dylanfalzone/Cansat_2023/README.md

# Cansat_2023
Design team project including design reviews and C code for a miniature satellite that placed 4th in the U.S. and 13th internationally at the 2023 Cansat Competition. For a full description of my work on this project, check my linkedin: https://www.linkedin.com/in/dylan-falzone-98a7b81b6/

* NOTE: The files in this repo were a collaborative effort from an incredible team. All members have given permission for the files to be viewed here.
