dylanfalzone/Cansat_2023/Cansat 2023 PDR Outline v1.1.pdf

# CanSat 2023

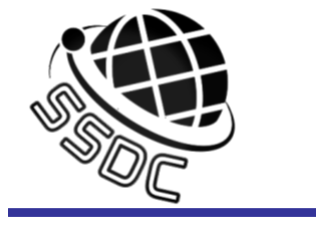
[picture p64: figure]
Team Logo Here (If You Want)

# Preliminary Design Review (PDR) Outline Version 1.0

# Team 1032 Yes we CANSAT

CanSat 2023 PDR: Team 1032 Yes we CANSAT | 1

(If You Want) | Presentation Outline
Presenter: Savari Datta | CanSat 2023 PDR: Team 1032 Yes we CANSAT | 2
Page # | Presentation Section | Presenter(s)
5 | Systems Overview | Savari Datta, Jordi Rey, Daniel Horton
20 | Sensor Subsystem Design | Dylan Falzone
30 | Descent Control Design | Jovana Markovic, Melissa Gonzalez Grospe
40 | Mechanical Subsystem Design | Daniel Horton, Christian Roque, Savari Datta, Melissa Gonzalez Grospe
55 | Communication and Data Handling (CDH) Subsystem Design | Yashas Shivaram, Max Epstein
65 | Electrical Power Subsystem (EPS) Design | Paolo D’Alessandro
70 | Flight Software (FSW) Design | Max Epstein
80 | Ground Control System (GCS) Design | Dylan Falzone, Max Epstein
87 | CanSat Integration and Test | Jordi Rey, Yashas Shivaram
95 | Mission Operations & Analysis | Jordi Rey
100 | Requirements Compliance | Savari Datta
108 | Management | Savari Datta

# (If You Want) Team Organization

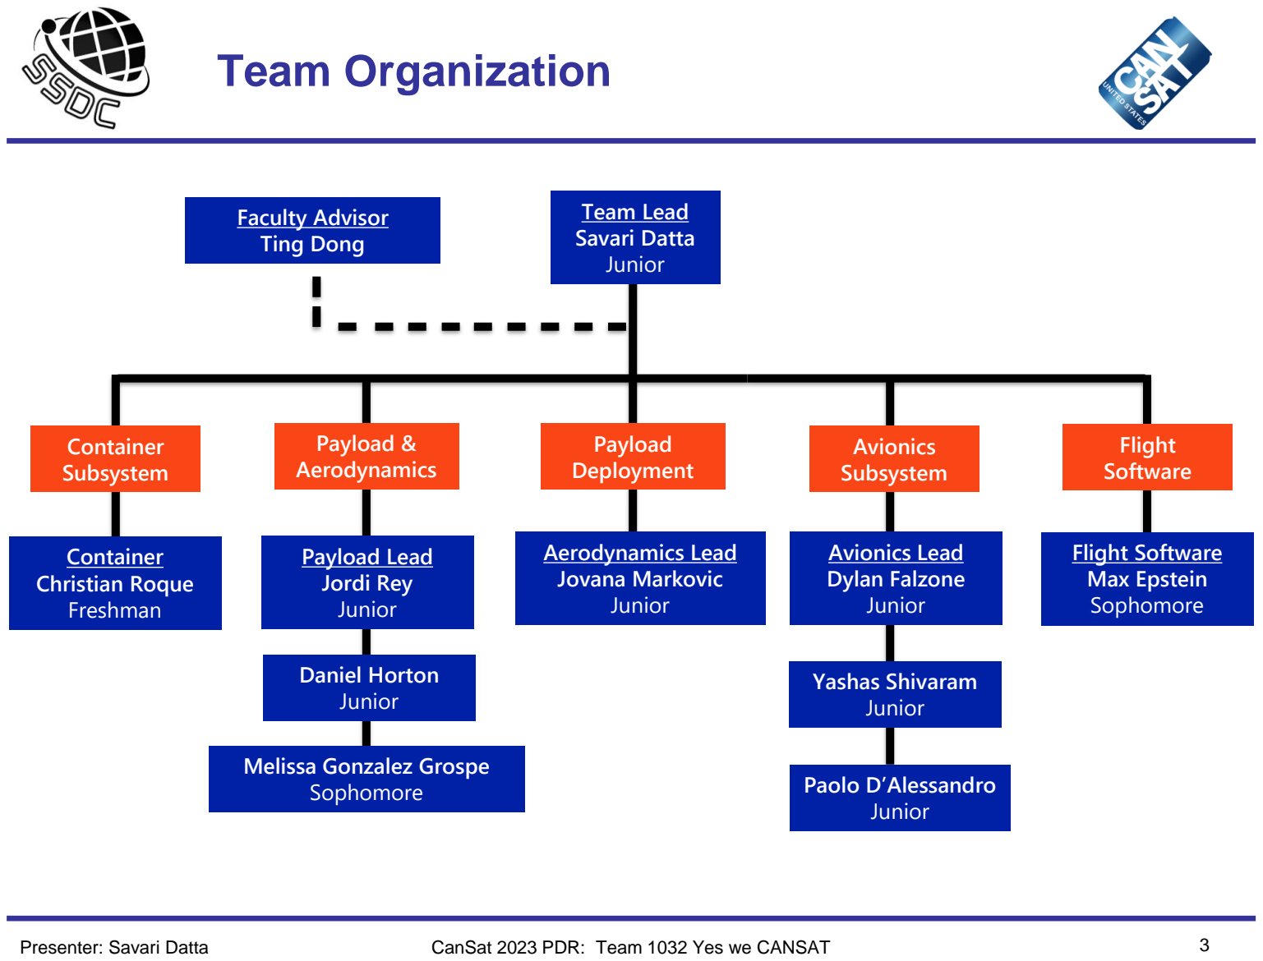
[picture p65: page 3]

Presenter: Savari Datta | CanSat 2023 PDR: Team 1032 Yes we CANSAT | 3

Team Lead
Savari Datta
Junior

Faculty Advisor
Ting Dong

Container
Subsystem

Payload
Deployment

Avionics
Subsystem

Container
Christian Roque
Freshman

Aerodynamics Lead
Jovana Markovic
Junior

Avionics Lead
Dylan Falzone
Junior

Payload &
Aerodynamics

Payload Lead
Jordi Rey
Junior

Melissa Gonzalez Grospe
Sophomore

Yashas Shivaram
Junior

Flight
Software

Flight Software
Max Epstein
Sophomore

Daniel Horton
Junior

Paolo D’Alessandro
Junior

(If You Want) | Acronyms
Presenter: Savari Datta | CanSat 2023 PDR: Team 1032 Yes we CANSAT | 4
Acronym | Meaning
ABS | Acrylonitrile Butadiene Styrene
CD | Drag Coefficient
CDH | Communication and Data Handling
CSV | Comma-Separated Values
DAC | Digital-to-Analog Converter
EPS | Electrical Power Subsystem
FSW | Flight Software
GCS | Ground Control System
GPS | Global Positioning System
IDE | Integrated Development Environment
LED | Light-Emitting Diode
MAE | Mechanical & Aerospace Engineering
Acronym | Meaning
MQTT | MQ Telemetry Transport
OTS | Off-the-shelf
PDR | Preliminary Design Review
PID | Proportional-Integral-Derivative
PWM | Pulse-Width Modulation
RPM | Revolutions per Minute
SMA | Subminiature Version A
SPI | Serial Peripheral Interface
SSDC | Space Systems Design Club
STEM | Science, Technology, Engineering, and Mathematics
UF | University of Florida

# Systems Overview

# Savari Datta, Jordi Rey, Daniel Horton

CanSat 2023 PDR: Team 1032 Yes we CANSAT | 5

(If You Want) | Mission Summary (1/2)
Presenter: Savari Datta | CanSat 2023 PDR: Team 1032 Yes we CANSAT | 6

## Main Objectives:

Design a CanSat that shall consist of a container and a payload. The probe shall simulate the sequence of a planetary probe

- The CanSat shall be launched to an altitude ranging from 670 meters to 725 meters above the launch site and deployed near apogee (peak altitude).
- The CanSat must survive the forces incurred at launch and deployment.
- Once the CanSat is deployed from the rocket, the CanSat shall descend using a parachute at a rate of 15 m/s.
- At 500 meters, the CanSat shall deploy a probe that shall open a heat shield.
- The heat shield will be used as an aerobraking device with a descent rate of 20 meters/second or less.
- When the probe reaches 200 meters, the probe shall deploy a parachute and slow the descent rate to 5 meters/second.
- Once the probe has landed, it shall attempt to upright itself and raise a flag 500 mm above the base of the probe.
- The video camera shall be pointed towards the ground during descent.

(If You Want) | Mission Summary (2/2)
Presenter: Savari Datta | CanSat 2023 PDR: Team 1032 Yes we CANSAT | 7

## Bonus Objectives:

A video camera shall be integrated into the container and point toward the probe. The camera shall record the event when the probe is released from the container. Video shall be in color with a minimum resolution of 640x480 pixels and a minimum of 30 frames per second.

- Will not be attempting bonus objective

## External Objectives:

- To promote STEM engagement at the university level
- To provide team members with valuable hands-on engineering project experience
that includes designing, manufacturing and testing of an aerospace system
- To challenge students with unique projects that require critical thinking
- To inspire underclassmen to continue participating in the annual CanSat competition at UF

(If You Want) | System Requirement Summary (1/6)
Presenter: Savari Datta | CanSat 2023 PDR: Team 1032 Yes we CANSAT | 8
Requirement Number | Description
1 | Total mass of the CanSat (science payloads and container) shall be 700 grams +/- 10 grams.
2 | CanSat shall fit in a cylindrical envelope of 125 mm diameter x 400 mm length. Tolerances are to be included to facilitate container deployment from the rocket fairing.
3 | The container shall not have any sharp edges to cause it to get stuck in the rocket payload section which is made of cardboard.
4 | The container shall be a fluorescent color; pink, red or orange.
5 | The container shall be solid and fully enclose the science probes. Small holes to allow access to turn on the science probes are allowed. The end of the container where the probe deploys may be open.
6 | The rocket airframe shall not be used to restrain any deployable parts of the CanSat.
7 | The rocket airframe shall not be used as part of the CanSat operations.
8 | The container’s parachute shall not be enclosed in the container structure. It shall be external and attached to the container so that it opens immediately when deployed from the rocket.
9 | The Parachutes shall be fluorescent Pink or Orange
10 | The descent rate of the CanSat (container and science probe) shall be 15 meters/second +/- 5m/s.
11 | 0 altitude reference shall be at the launch pad.

(If You Want) | System Requirement Summary (2/6)
Presenter: Savari Datta | CanSat 2023 PDR: Team 1032 Yes we CANSAT | 9
Requirement Number | Description
12 | All structures shall be built to survive 15 Gs of launch acceleration.
13 | All structures shall be built to survive 30 Gs of shock
14 | All electronics and mechanical components shall be hard mounted using proper mounts such as standoffs, screws, or high-performance adhesives.
15 | All mechanisms shall be capable of maintaining their configuration or states under all forces.
16 | Mechanisms shall not use pyrotechnics or chemicals.
17 | Mechanisms that use heat (e.g., nichrome wire) shall not be exposed to the outside environment to reduce potential risk of setting vegetation on fire.
18 | Both the container and payload shall be labeled with team contact information including email address.
19 | Cost of the CanSat shall be under $1000. Ground support and analysis tools are not included in the cost. Equipment from previous years should be included in this cost, based on current market value.
20 | XBEE radios shall be used for telemetry. 2.4 GHz Series radios are allowed. 900 MHz XBEE radios are also allowed.
21 | XBEE radios shall have their NETID/PANID set to their team number.
22 | XBEE radios shall not use broadcast mode.
23 | The container and probe shall include an easily accessible power switch that can be accessed without disassembling the CanSat and science probes and in the stowed configuration.

(If You Want) | System Requirement Summary (3/6)
Presenter: Savari Datta | CanSat 2023 PDR: Team 1032 Yes we CANSAT | 10
Requirement Number | Description
24 | The probe shall include a power indicator such as an LED or sound generating device that can be easily seen or heard without disassembling the CanSat and in the stowed state.
25 | An audio beacon is required for the probe. It shall be powered after landing.
26 | The audio beacon shall have a minimum sound pressure level of 92 dB, unobstructed.
27 | Battery source may be alkaline, Ni-Cad, Ni-MH or Lithium. Lithium polymer batteries are not allowed. Lithium cells must be manufactured with a metal package similar to 18650 cells. Coin cells are allowed.
28 | An easily accessible battery compartment shall be included allowing batteries to be installed or removed in less than a minute and not require a total disassembly of the CanSat.
29 | Spring contacts shall not be used for making electrical connections to batteries. Shock forces can cause momentary disconnects.
30 | The CanSat shall operate during the environmental tests laid out in Section 3.5.
31 | The CanSat shall operate for a minimum of two hours when integrated into the rocket.
32 | The probe shall be released from the container when the CanSat reaches 500 meters.
33 | The probe shall deploy a heat shield after leaving the container.
34 | The heat shield shall be used as an aerobrake and limit the descent rate to 20 m/s or less.
35 | At 200 meters, the probe shall release a parachute to reduce the descent rate to 5 m/s +/- 1m/sec.

(If You Want) | System Requirement Summary (4/6)
Presenter: Savari Datta | CanSat 2023 PDR: Team 1032 Yes we CANSAT | 11
Requirement Number | Description
36 | Once landed, the probe shall upright itself.
37 | After uprighting, the probe shall deploy a flag 500 mm above the base of the probe when the probe is in the upright position.
38 | The probe shall transmit telemetry once per second.
39 | The probe telemetry shall include altitude, air pressure, temperature, battery voltage, probe tilt angles, command echo, and GPS coordinates that include latitude, longitude, altitude and number of satellites tracked.
40 | The probe shall include a video camera pointing down to the ground.
41 | The video camera shall record the flight of the probe from release to landing.
42 | The video camera shall record video in color and with a minimum resolution of 640x480.
44 | The flight software shall maintain a count of packets transmitted which shall increment with each packet transmission throughout the mission. The value shall be maintained through processor resets
45 | The probe shall maintain mission time throughout the whole mission even with processor resets or momentary power loss.
46 | The probe shall have its time set to within one second UTC time prior to launch.
47 | The probe flight software shall support simulated flight mode where the ground station sends air pressure values at a one second interval using a provided flight profile csv file.
48 | In simulation mode, the flight software shall use the radio uplink pressure values in place of the pressure sensor for determining the container altitude.

(If You Want) | System Requirement Summary (5/6)
Presenter: Savari Datta | CanSat 2023 PDR: Team 1032 Yes we CANSAT | 12
Requirement Number | Description
49 | The container flight software shall only enter simulation mode after it receives the SIMULATION ENABLE and SIMULATION ACTIVATE commands.
50 | The ground station shall command the CanSat to start calibrating the altitude to zero when the CanSat is on the launch pad prior to launch.
51 | The ground station shall generate csv files of all sensor data as specified in the Telemetry Requirements section.
52 | Telemetry shall include mission time with 0.01 second or better resolution.
53 | Configuration states such as zero altitude calibration shall be maintained in the event of a processor reset during launch and mission.
54 | Each team shall develop their own ground station.
55 | All telemetry shall be displayed in real time during descent on the ground station.
56 | All telemetry shall be displayed in engineering units (meters, meters/sec, Celsius, etc.)
57 | Teams shall plot each telemetry data field in real time during flight.
58 | The ground station shall include one laptop computer with a minimum of two hours of battery operation, XBEE radio and a hand-held antenna.
59 | The ground station must be portable so the team can be positioned at the ground station operation site along the flight line. AC power will not be available at the ground station operation site
60 | The ground station software shall be able to command the container to operate in simulation mode by sending two commands, SIMULATION ENABLE and SIMULATION ACTIVATE.

(If You Want) | System Requirement Summary (6/6)
Presenter: Savari Datta | CanSat 2023 PDR: Team 1032 Yes we CANSAT | 13
Requirement Number | Description
61 | When in simulation mode, the ground station shall transmit pressure data from a csv file provided by the competition at a 1 Hz interval to the CanSat.

# System Level CanSat Configuration Trade & Selection

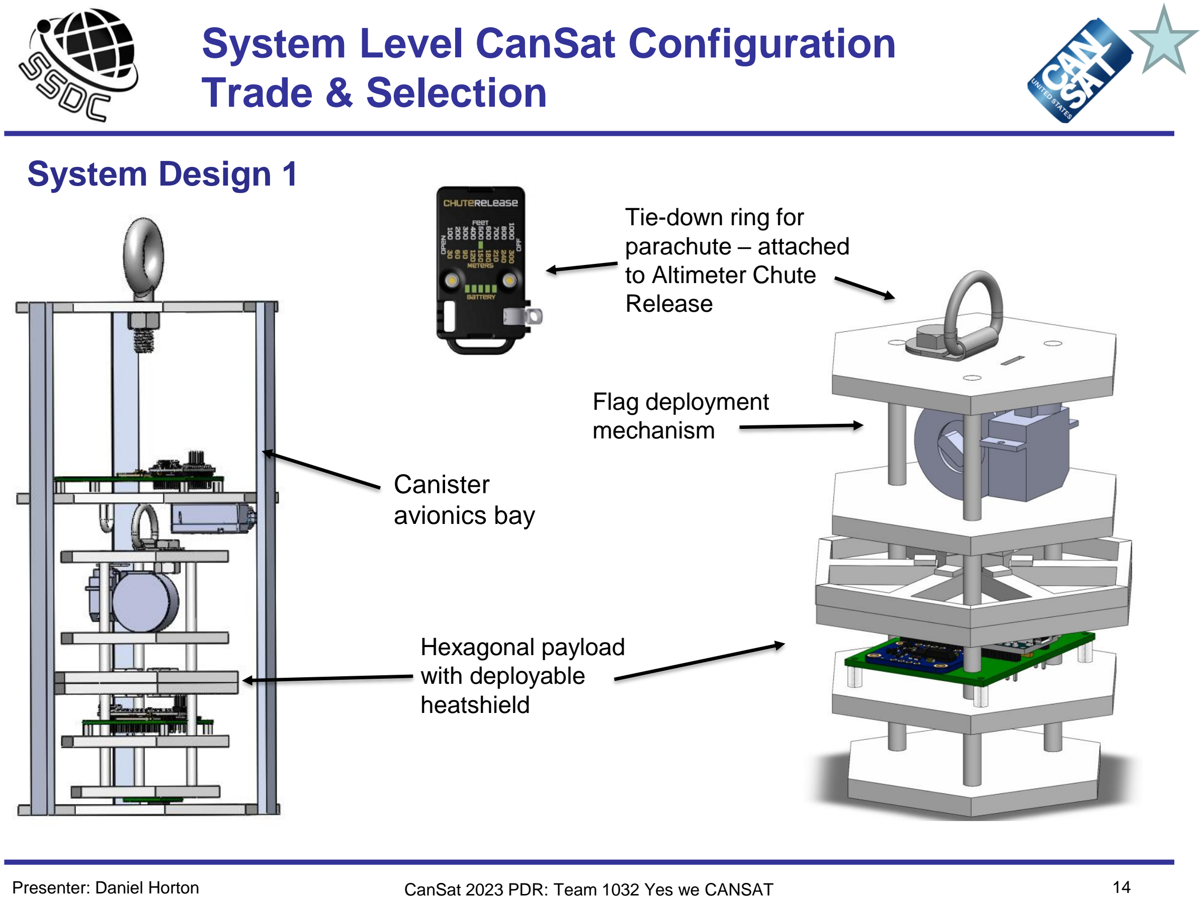
[picture p66: page 14]

(If You Want)

Presenter: Daniel Horton | CanSat 2023 PDR: Team 1032 Yes we CANSAT | 14

## System Design 1

Canister
avionics bay

Hexagonal payload
with deployable
heatshield

Flag deployment
mechanism

Tie-down ring for
parachute – attached
to Altimeter Chute
Release

# System Level CanSat Configuration Trade & Selection

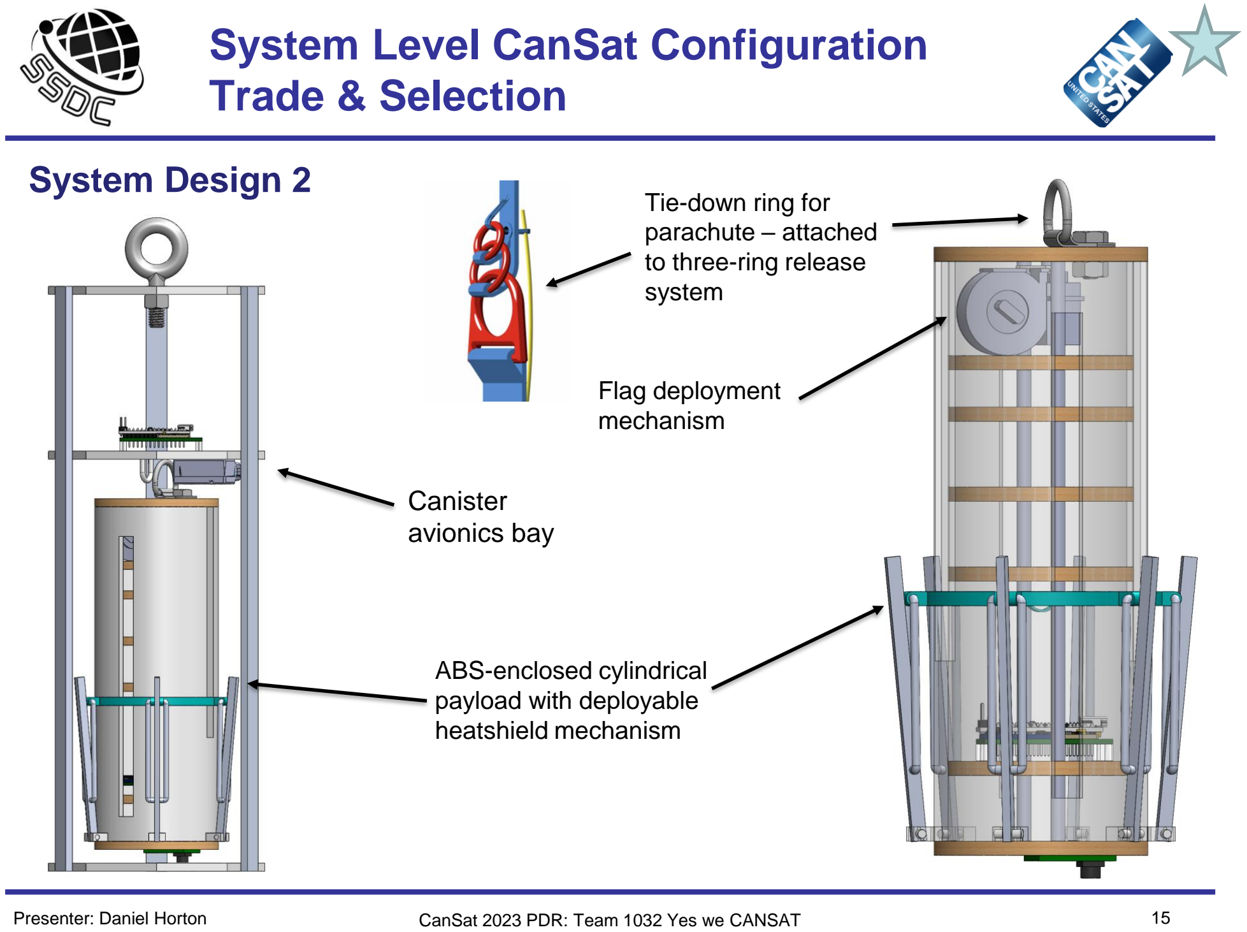
[picture p67: page 15]

(If You Want)

Presenter: Daniel Horton | CanSat 2023 PDR: Team 1032 Yes we CANSAT | 15

## System Design 2

Canister
avionics bay

ABS-enclosed cylindrical
payload with deployable
heatshield mechanism

Flag deployment
mechanism

Tie-down ring for
parachute – attached
to three-ring release
system

(If You Want) | System Level Configuration Selection
Presenter: Daniel Horton | CanSat 2023 PDR: Team 1032 Yes we CANSAT | 16

Chosen Design: System 1

Configuration | Reasoning
9-sided polygon Canister | Simple to manufacture, light-weight design, composed only of ABS plastic plates, fiberglass eyebolt and aluminum supports fixed together using epoxy.
Hexagonal payload configuration | ABS plates with 6 spring-deployed arms for the aerobraking-heatshield, and aluminum rods supporting the plates. More compact design with fewer unique parts required, making it easier to manufacture.
Altimeter Chute Release | Electronic chute release; does not require any other mechanical components on the payload to deploy the parachute when the desired altitude is reached.

# (If You Want) Physical Layout

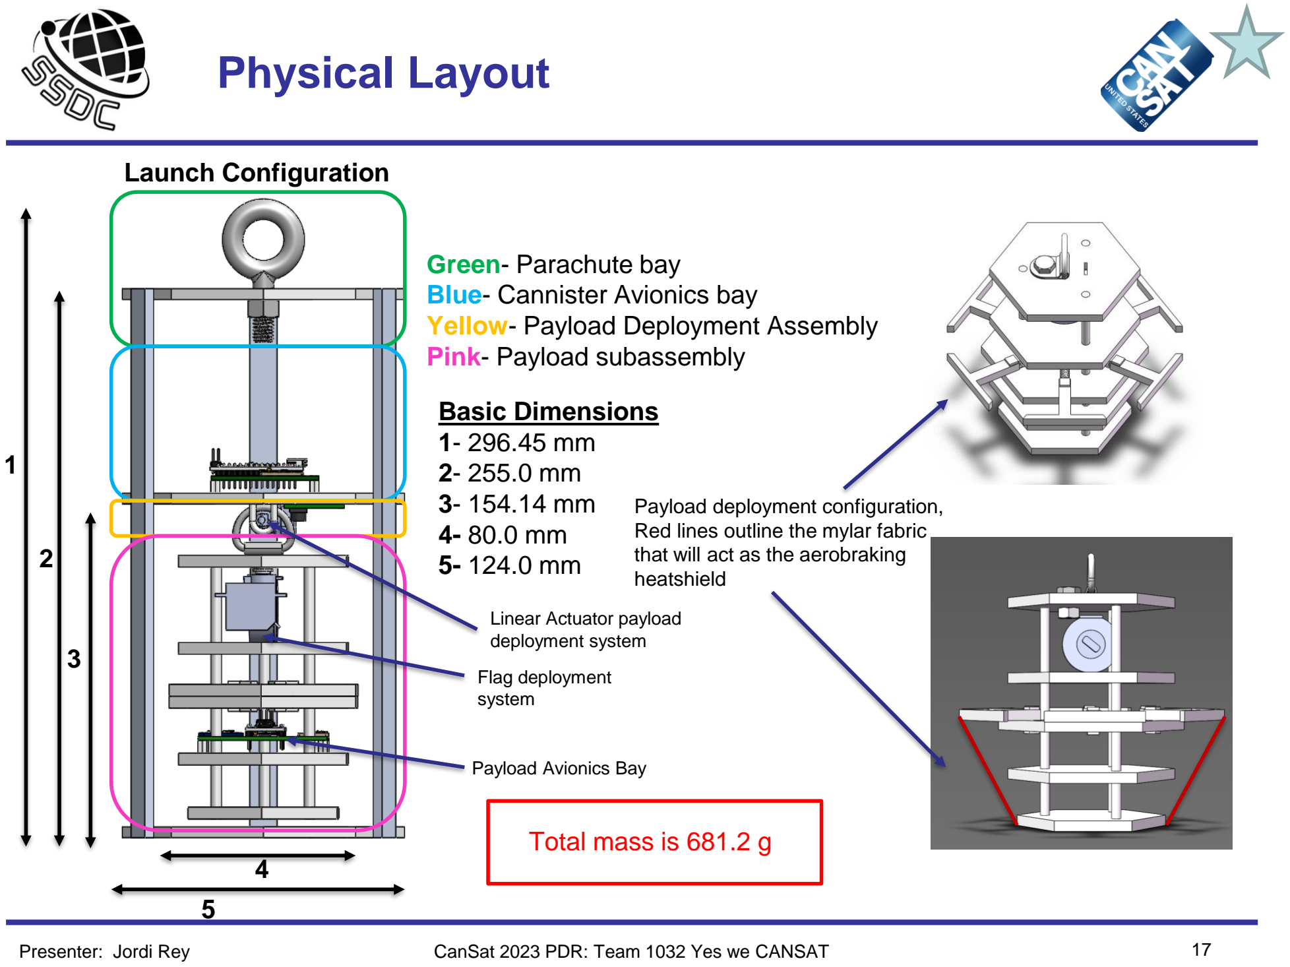
[picture p68: page 17]

Presenter: Jordi Rey | CanSat 2023 PDR: Team 1032 Yes we CANSAT | 17

Launch Configuration

1

2

3

4
5

Basic Dimensions
1- 296.45 mm
2- 255.0 mm
3- 154.14 mm
4- 80.0 mm
5- 124.0 mm

Green- Parachute bay
Blue- Cannister Avionics bay
Yellow- Payload Deployment Assembly Pink- Payload subassembly

Flag deployment
system

Linear Actuator payload
deployment system

Payload Avionics Bay

Payload deployment configuration, Red lines outline the mylar fabric that will act as the aerobraking heatshield

Total mass is 681.2 g

(If You Want) | System Concept of Operations

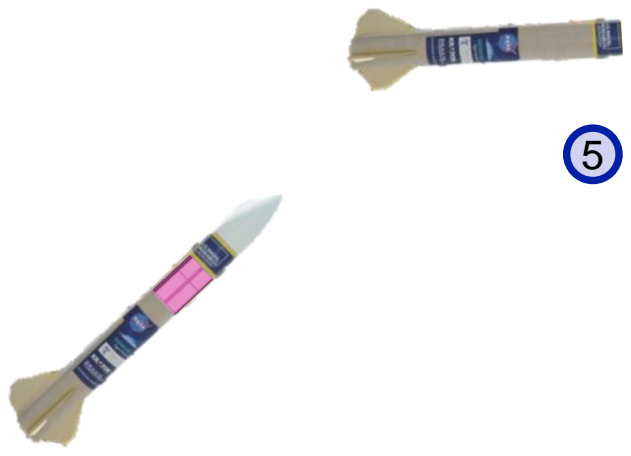
[picture p69: figure]
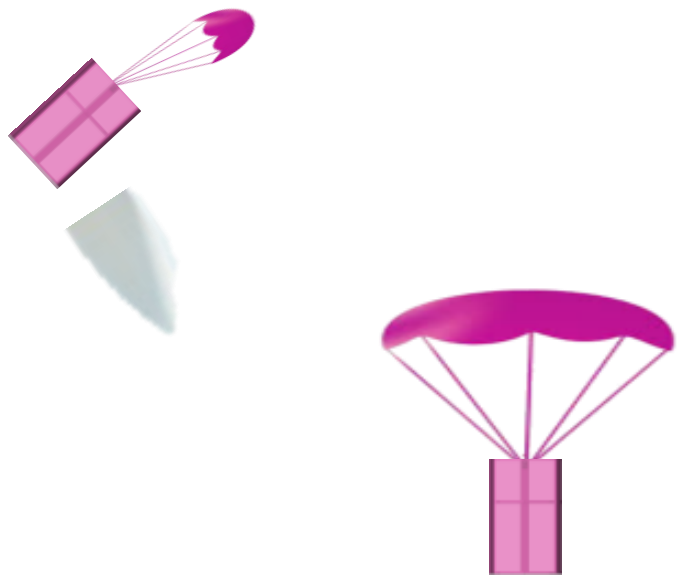
[picture p70: figure]
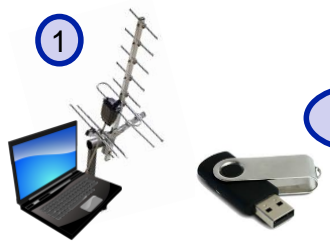
[picture p71: figure]

Presenter: Jordi Rey | CanSat 2023 PDR: Team 1032 Yes we CANSAT | 18
1. Set up ground station
2. Power on CanSat
3. Place CanSat into rocket
4. Rocket is launched
5. At 670-725m the CanSat separates and parachute opens
6. At 400m a probe will be released from the CanSat, which will deploy an aerobraking heat shield, with a camera facing the ground at all times
7. At 200m the probe will deploy a parachute too reduce descent rate
8. Probe will land upright
9. Probe will deploy a flag 500mm above the base of the probe
10. Recovery crew tracks and collects CanSat
11. FSW obtains and saves flight data & video recording to thumb drive ¹

2
3

4

6

7

9 | 8
10

11

(If You Want) | Launch Vehicle Compatibility

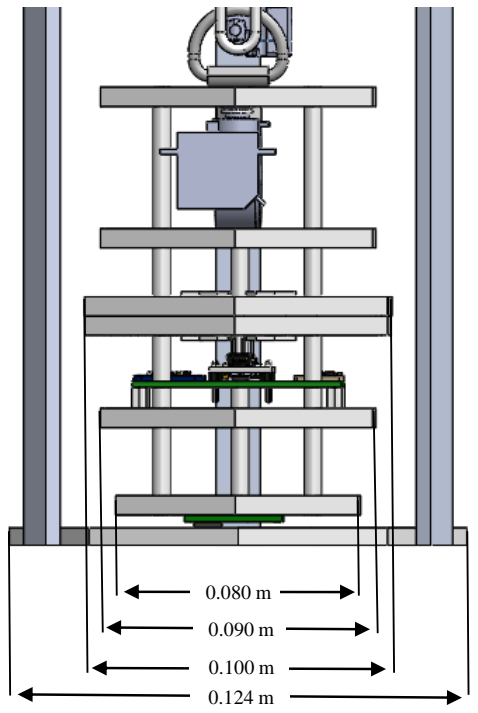
[picture p72: figure]

Presenter: Jordi Rey | CanSat 2023 PDR: Team 1032 Yes we CANSAT | 19

# Payload Clearance

NOTE: The first two
plates are the same
size as the third plate
(0.090 m)

Sharp edges in this section will be sanded down

# Sensor Subsystem Design

# Dylan Falzone

CanSat 2023 PDR: Team 1032 Yes we CANSAT | 20

(If You Want) | Sensor Subsystem Overview
Presenter: Dylan Falzone | CanSat 2023 PDR: Team 1032 Yes we CANSAT | 21
Sensor Type | Model | Purpose | CanSat Location
GPS module | Adafruit Ultimate | Determine location coordinates (X,Y,Z) & exact time | Payload
Pressure Sensor | Adafruit BMP280 | Measure altitude of Container & Payload | Container, Payload
Rotational Sensor | BNO055 | Measure gyro readings in degrees per second, angular acceleration, and magnetometer readings in gauss | Payload
Temperature Sensor | BNO055 | Measure temperature readings | Payload
Camera | Arducam Mini 2MP Plus | View and record Earth’s terrain during descendent | Payload

(If You Want)

# Payload Air Pressure Sensor Trade & Selection


22

Sensors | Current (at 1Hz) (µA) | Temperature Range (°C) | Interfaces | Resolution (hPa) | Voltage Usage (V) | Size (mm) L x W x H | Weight (g) | Price ($)
Adafruit MPRLS | 3.6 | -40 to 85 | I2C, SPI | .30 | 1.65 ~ 3.6 | 17.8 x 16.7 x 7.5 | 1.1 | 14.95
BMP280 Adafruit | 2.7 | -40 to 85 | I2C, SPI | .0016 | 1.71 ~ 3.6 | 19.2 x 17.9 x 2.9 | 1.3 | 9.95
MPL3115A2 | 8.5 | -40 to 85 | I2C | .015 | 1.95~ 3.6 | 18 x 19 x 2 | 1.2 | 9.95
Selection | Reasoning for the selection
Adafruit BMP280 | - Lower current draw in comparison to . other inspected sensors - Greater resolution in comparison to . other inspected sensors
Presenter: Dylan Falzone | CanSat 2023 PDR: Team 1032 Yes we CANSAT

(If You Want)

# Payload GPS Sensor Trade & Selection

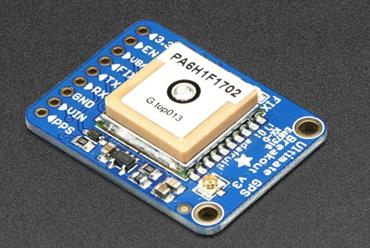
[picture p73: figure]

23

Sensors | Update Rate (Hz) | Operating Voltage (V) | Current (Tracking) (mA) | Interfaces | Size (mm) L x W x H | Weight (g) | Price ($)
Adafruit Ultimate Breakout v3 | 10 | 3.0 – 5.0 | 20 | I2C, SPI, UART | 25.5 x 35 x 6.5 | 8.5 | 29.95
uBlox NEO M8N | 10 | 2.7 – 3.6 | 23 | I2C, SPI, UART | 27.6 x 26.6 x 2.4 | 9.8 | 11.59
Titan X1 | 10 | 3.0 – 4.3 | 25 | I2C, SPI, UART | 12.5 x 12.5 6.5 | 4 | 69.84
Selection | Reasoning for the selection
Adafruit Ultimate | - Lower current draw during . tracking in comparison to other . inspected sensors - Previous experience with sensor . and familiarity with Arduino - Availability
Presenter: Dylan Falzone | CanSat 2023 PDR: Team 1032 Yes we CANSAT

(If You Want)

# Payload Air Temperature Sensor Trade & Selection


24

Sensors | Temperature Range (°C) | Interfaces | Voltage Usage (V) | Size (mm) L x W x H | Weight (g) | Price ($)
HTU31 Temperature & Humidity Sensor | -40 to 125 | I2C | 3.3 – 5.5 | 25.5 x 17.7 x 4.6 | 1.6 | 5.95
BNO055 | -40 to 85 | I2C or UART | 1.7 – 3.6 | 20 x 27 x 4 | 3 | 34.95
Sensirion SHT31-D | -40 to 125 | I2C | 2.4 – 5.5 | 12.7 x 18 x 2.6 | 0.8 | 13.95
Presenter: Dylan Falzone | CanSat 2023 PDR: Team 1032 Yes we CANSAT
Selection | Reasoning for the selection
BNO 055 | - Familiarity with sensor - Also meets our requirements for . the payload’s temperature sensor - Availability

(If You Want)

# Payload Tilt Sensor Trade & Selection

25

Selection | Reasoning for the selection
BNO 055 | - Familiarity with sensor - Also meets our requirements for . the payload’s temperature sensor - Availability
Sensors | Temperature Range (°C) | Interfaces | Voltage Usage (V) | Size (mm) L x W x H | Weight (g) | Price ($)
HTU31 Temperature & Humidity Sensor | -40 to 125 | I2C | 3.3 – 5.5 | 25.5 x 17.7 x 4.6 | 1.6 | 5.95
BNO055 | -40 to 85 | I2C or UART | 1.7 – 3.6 | 20 x 27 x 4 | 3 | 34.95
Sensirion SHT31-D | -40 to 125 | I2C | 2.4 – 5.5 | 12.7 x 18 x 2.6 | 0.8 | 13.95
Presenter: Dylan Falzone | CanSat 2023 PDR: Team 1032 Yes we CANSAT

(If You Want)

# Payload Battery Voltage Sensor Trade & Selection


Presenter: Dylan Falzone | CanSat 2023 PDR: Team 1032 Yes we CANSAT | 26
Sensors | Resolution | Interfaces | Size (mm) L x W x H | Weight (g) | Price ($)
Adafruit INA219 | 12 bit | I2C | 25.6 x 20.4 x 4.7 | 4.6 | 9.95
Adafruit INA260 | 16 bit | I2C | 22.9 x 22.8 x 2.7 | 2 | 9.95
Precision LM4040 | 12 bit | I2C | 16 x 12.5 x 2.5 | 0.7 | 7.50
Selection | Reasoning for the selection
Adafruit INA260 | - Greater resolution bit compared to other sensors - Previous experience and familiarity with sensor - Availability

(If You Want) | Payload Camera Trade & Selection

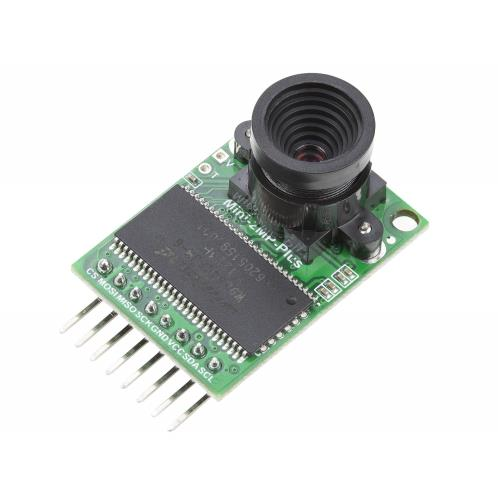
[picture p74: figure]

Presenter: Dylan Falzone | CanSat 2023 PDR: Team 1032 Yes we CANSAT | 27
Selection | Reasoning for the selection
Arducam Mini 2MP Plus | - Compatibility with microprocessor - Lower current draw in comparison to other inspected sensors
Name | Price ($) | Weight (g) | Size (mm) | Operating Voltage (V) | Current Draw (mA) | Framerate (fp s)
Miniature TTL Serial JPEG Camera | 34.95 | 3 | 20 x 28 | 3.3 - 5.0 | 75 | 30
Arducam Mini 2MP Plus | 25.99 | 20 | 24 x 34 | 3.3 - 5.0 | 20 | 30

# (If You Want) Audio Beacon Trade & Selection

28

Name | Pressure (dB) Min Sound | Weight (g) | Operating Voltage (V) | Mini Current Draw (mA)
PS1240P02BT | 60 | 1 | 3 | 40
IE092505-1 | 80 | 1 | 5 | 30

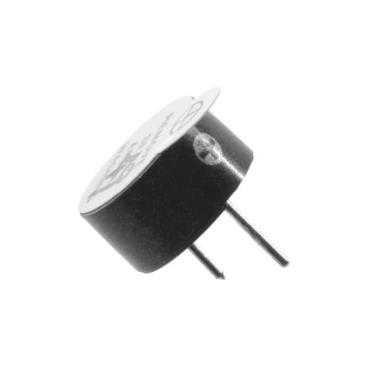
[picture p75: figure]

Selection | Reasoning for the selection
IE092505-1 | - Compatibility with microprocessor - Meet sound level requirement
Presenter: Dylan Falzone | CanSat 2023 PDR: Team 1032 Yes we CANSAT

# (If You Want) Bonus Camera Trade and Selection

- N/A
Presenter: Dylan Falzone | CanSat 2023 PDR: Team 1032 Yes we CANSAT | 29

# Descent Control Design

# Jovana Markovic, Melissa Gonzalez Grospe

CanSat 2023 PDR: Team 1032 Yes we CANSAT | 30

# (If You Want) Descent Control Overview (1/3)

Container Descent Control System:
System: Parachute
System Components: Hexagonal Parachute Parachute Chords
Eyebolt

System Overview: The eyebolt is screwed into the can. The parachute is attached to the eyebolt using chords. The parachute sits atop the can prior to the can’s ejection from the rocket after which the parachute will deploy naturally

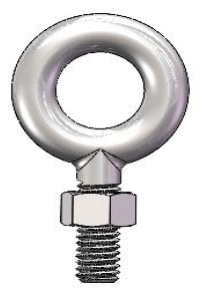
[picture p76: figure]

Presenter: Jovana Markovic | CanSat 2023 PDR: Team 1032 Yes we CANSAT | 31

# (If You Want) Descent Control Overview (2/3)

Payload Descent Control System:
System: Parachute
System Components: Hexagonal Parachute Parachute Chords
Altimeter Chute Release

System Overview: The parachute is attached to a tie down ring which is screwed into the payload. The parachute will sit atop the payload held together by the device until the desired altitude is reached, after which the device will release, and the parachute will be allowed to deploy naturally

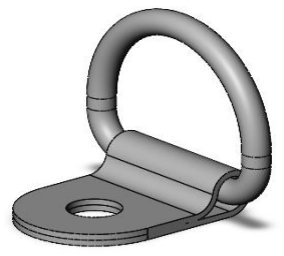
[picture p77: figure]

Presenter: Jovana Markovic | CanSat 2023 PDR: Team 1032 Yes we CANSAT | 32

# (If You Want) Descent Control Overview (3/3)

Aerobraking:
System: Hexagonal Prism Payload Shape System Components: Hexagonal Plates Extendable arms which serve to enlarge one of the plates Spring system which releases the arms into place
Poles for vertical alignment

System Overview: The spring system will allow for the arm attachments to remain compressed while the payload is within the can. Following deployment from the can, the arms will extend and enlarge the surface area of the central hexagonal plate. The enlarged plate will create a truncated hexagonal pyramid which will increase drag.

Presenter: Jovana Markovic | CanSat 2023 PDR: Team 1032 Yes we CANSAT | 33

(If You Want)

# Container Descent Control Strategy Selection and Trade

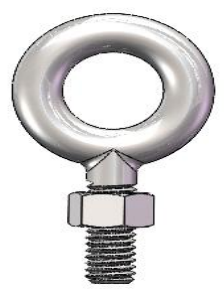
[picture p78: figure]

Presenter: Jovana Markovic | CanSat 2023 PDR: Team 1032 Yes we CANSAT | 34
Decent Control | Eyebolt Design | Tie Down Ring Design
Objective | Weighting Factor | Parameter | Mag. | Score | Value | Mag. | Score | Value
Mass | 0.30 | grams | 10.1 | 9.4 | 2.8 | 15.6 | 6.0 | 1.8
Durability | 0.10 | discussion | good | 8.0 | 0.8 | okay | 6.0 | 0.6
Stability | 0.30 | discussion | great | 10.0 | 3.0 | good | 8.0 | 2.4
Size (Vertical Height) | 0.20 | mm | 66.5 | 3.6 | 0.7 | 23.8 | 10.0 | 2.0
Simplicity | 0.10 | # of parts | 2.0 | 10.0 | 1.0 | 4.0 | 5.0 | 0.5
Overall value | | | | | 8.3 | | | 7.3

Justification: The Eye Bolt design was selected to attach the parachute to the can as it weighs less and requires fewer parts to be installed in comparison to the Tie Down Ring

Configuration A:
Eyebolt

Configuration B:
Tie Down Ring

(If You Want)

# Payload Aerobraking Descent Control Strategy Selection and Trade

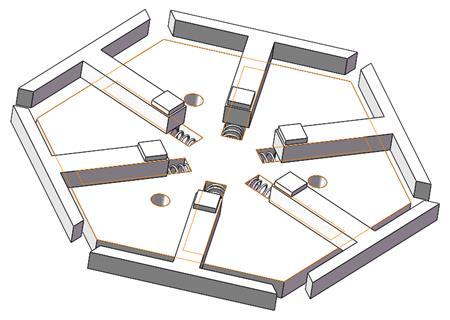
[picture p79: figure]
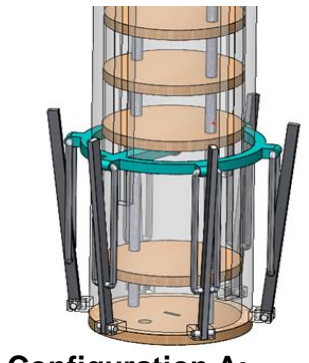
[picture p80: figure]

Presenter: Melissa Gonzalez Grospe | CanSat 2023 PDR: Team 1032 Yes we CANSAT | 35
Design | Description | Identified Issues | Evaluation
Umbrella Mechanism | Following deployment from the can, six rods will release naturally and extend at an angle in order to create an aerodynamic parabolic shape. | Manufacturing the rods to allow for easy movement proved to be difficult. Lack of storage space for electronics. | Discarded
Spring Loaded Hexagon | Following deployment from the can, a spring system will allow for rods to extend on the top plate of the payload. The top plate will now be larger, which will create a cone shaped payload. | Design is heavier than preferred. The bottom of the payload is a hexagonal plate which may disturb the aerodynamics. | Selected, allows for necessary deceleration while being cheaper and easier to manufacture

Configuration A:
Umbrella Mechanism

Configuration B:
Spring Loaded Hexagon

(If You Want)

# Payload Aerobraking Descent Stability Control Strategy Selection and Trade

Presenter: Melissa Gonzalez Grospe | CanSat 2023 PDR: Team 1032 Yes we CANSAT | 36
Method | Description | Identified Issues | Evaluation
Bottom Heavy Payload Design | Designing the payload in a manner in which most of the mechanisms are located towards the center bottom of the payload and distributing the contents of the payload such as the electronics toward the bottom would ensure that the payload lands upright. | Requires extensive testing. Adequate space for the configuration may be an issue. The payload contents may be more susceptible to damage from the shock of deployment in this configuration. | Selected, simple design and preliminary testing has already been completed.
Spinning Payload | The spinning serves the gyroscopically stabilize the payload. | Difficult to implement. The spinning could have a significant effect on the speed at which the payload is descending. | Discarded, impractical

(If You Want)

# Payload Parachute Descent Control Strategy Selection and Trade

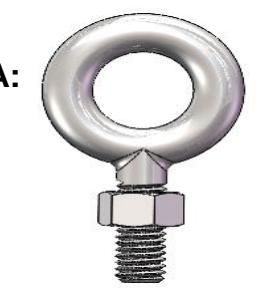
[picture p81: figure]

Presenter: Melissa Gonzalez Grospe | CanSat 2023 PDR: Team 1032 Yes we CANSAT | 37
Method | Description | Identified Issues | Evaluation
Eyebolt | Consists of a 6.6675 cm long shank which anchors the eye bolt to the payload and a ring at the top which allows for attaching the parachute. Would require an additional nut to hold the eye bolt in place. | Vertical height exceeds allowable value. Would add considerable height to the payload design, possibly requiring modifications to the can design in order to accommodate the height. | Discarded
Tie Down Ring | The tie down ring consists of a D shaped ring which is securely nestled within a base plate. The base plate is folded over and through the ring to secure it. The tie down ring is secured to the payload using an additional nut and screw. | Heavier than preferable. More complex manufacturing compared to eyebolt design. Requires more parts. | Selected, shorter possible shank length saves space, shorter overall height.

Configuration A:
Eyebolt

Configuration B:
Tie Down Ring

# (If You Want) Descent Rate Estimates (1/2)

# Decent Rate Estimates for the following Configurations

# Assumptions

- ~2.7 m/s winds
- Total weight is 700 grams
- Payload weight is 300 grams
- 0.53m Hexagon Parachute for Payload
Presenter: Melissa Gonzalez Grospe | CanSat 2023 PDR: Team 1032 Yes we CANSAT | 38
Configuration | Device | Desired Rate | Decent Rate Estimate | Method of Calculation
CanSat with payload | Parachute | 15 ± 5 m/s | 15.3 m/s | Parachute calculations
Payload aerobraking | Umbrella Device | less than 20 m/s | 11.3 ± 3.1 m/s | Drop Testing
Payload parachute released | Parachute | 5 ± 1 m/s | 5.89 ± 1.1 m/s | Drop Testing

# (If You Want) Descent Rate Estimates (2/2)

# Testing Information

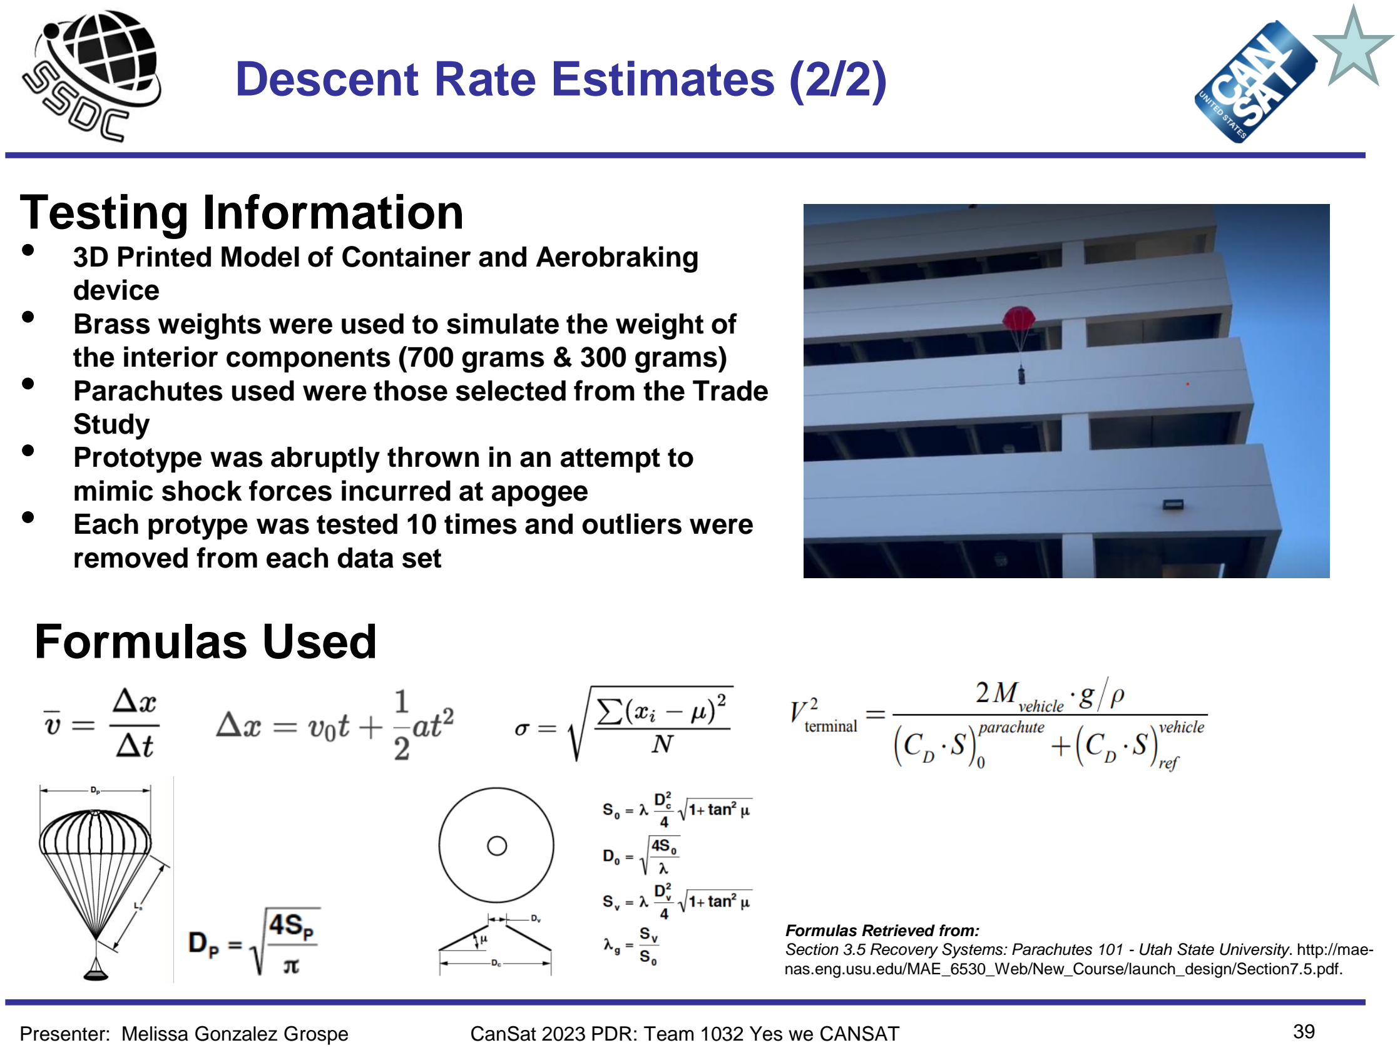
[picture p82: page 39]

- 3D Printed Model of Container and Aerobraking

device
- Brass weights were used to simulate the weight of

the interior components (700 grams & 300 grams)
- Parachutes used were those selected from the Trade

Study
- Prototype was abruptly thrown in an attempt to

mimic shock forces incurred at apogee
- Each protype was tested 10 times and outliers were

removed from each data set

Presenter: Melissa Gonzalez Grospe | CanSat 2023 PDR: Team 1032 Yes we CANSAT | 39

# Formulas Used

Formulas Retrieved from:
Section 3.5 Recovery Systems: Parachutes 101 - Utah State University. http://mae-nas.eng.usu.edu/MAE_6530_Web/New_Course/launch_design/Section7.5.pdf.

# Mechanical Subsystem Design

# Daniel Horton, Christian Roque, Savari Datta, Melissa Gonzalez Grospe

CanSat 2023 PDR: Team 1032 Yes we CANSAT | 40

(If You Want) | Mechanical Subsystem Overview

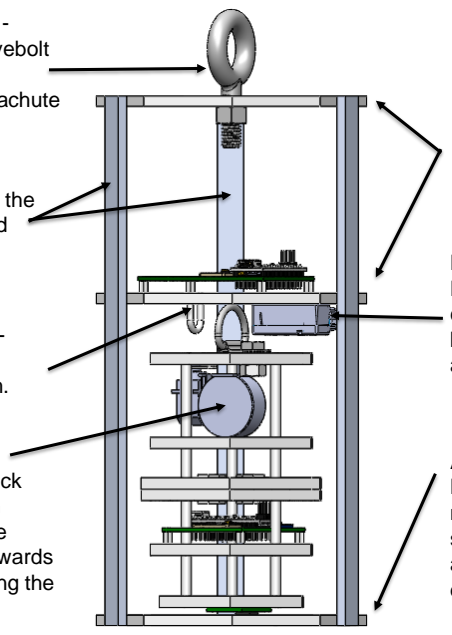
[picture p83: figure]

Presenter: Daniel Horton | CanSat 2023 PDR: Team 1032 Yes we CANSAT | 41

ABS Platforms -
Nine sided levels add structural support for mounting aluminum rods/supports on the sides, parachute attachment, and
electronics.

Aluminum Supports -
Aluminum bar stock fixed to the ABS platforms provides rigid support for the can shape.

Parachute Attachment -
Lightweight fiberglass eyebolt providing mechanical
connection between parachute and can.

ABS Nonagon Ring -
Bottom platform is an open nine-sided ring, providing structural support while still allowing the payload to
drop through.

Linear Actuator -
Holds the payload inside the container when deployed. Can be retracted to release payload at desired altitude.

Flag Deployment – a
container will house a clock spring that will be used in reverse to simulate a tape measure that pushes outwards rather than inwards, raising the flag

Payload Securement Ring -
Used to stop payload from
sliding off linear actuator arm.

(If You Want)

# Container Mechanical Layout of Components Trade & Selection (1/2)

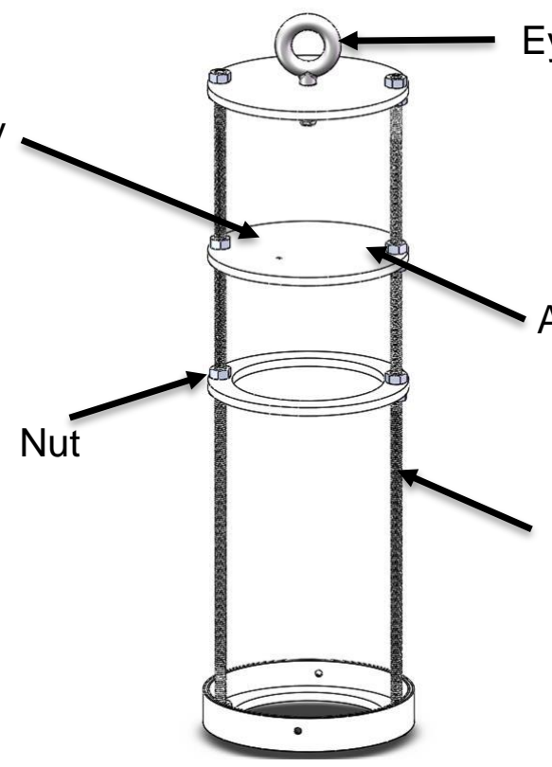
[picture p84: figure]
Nut

Presenter: Christian Roque | CanSat 2023 PDR: Team 1032 Yes we CANSAT | 42
Design | Description | Materials | Evaluation
Circular Container | Circular shaped container with four levels held together by 2 aluminum rods and 16 corresponding nuts. | Eyebolt (1) – Fiberglass Rod (2) - Aluminum Nut (17) - Aluminum Plates (4) - ABS Plastic | Discarded, not enough space for electrical components and payload to fit

Configuration A: Circular Container

Eyebolt

Aluminum Rod

ABS Plates

Avionics Bay

(If You Want)

# Container Mechanical Layout of Components Trade & Selection (2/2)

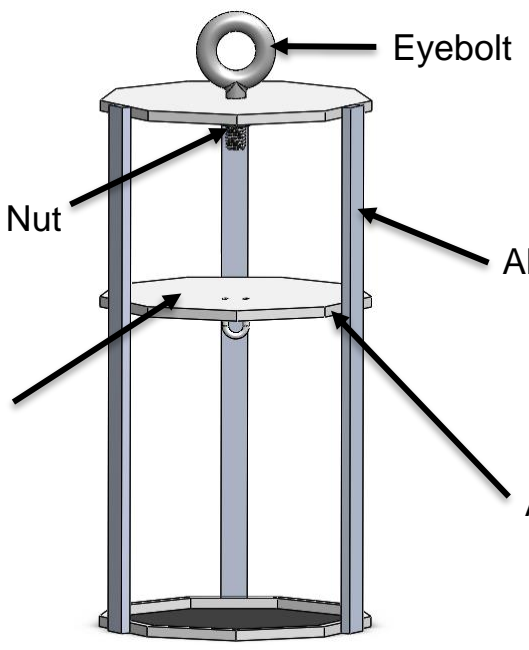
[picture p85: figure]
Eyebolt; Nut

Presenter: Christian Roque | CanSat 2023 PDR: Team 1032 Yes we CANSAT | 43
Design | Description | Materials | Evaluation
Nonagon Container | Nonagon shaped container with three levels held together by 3 aluminum supports using epoxy. | Eyebolt (1) – Fiberglass Supports (3) – Aluminum Plates (3) - ABS Plastic Nut (1) - Aluminum | Selected, more space on each plate, 3 supports make it structurally intact, less components makes it simpler and much lighter in weight.

Configuration B: Nonagon Container

Aluminum Support Rods

ABS Plate

Avionics Bay

# Container Parachute Attachment Mechanism

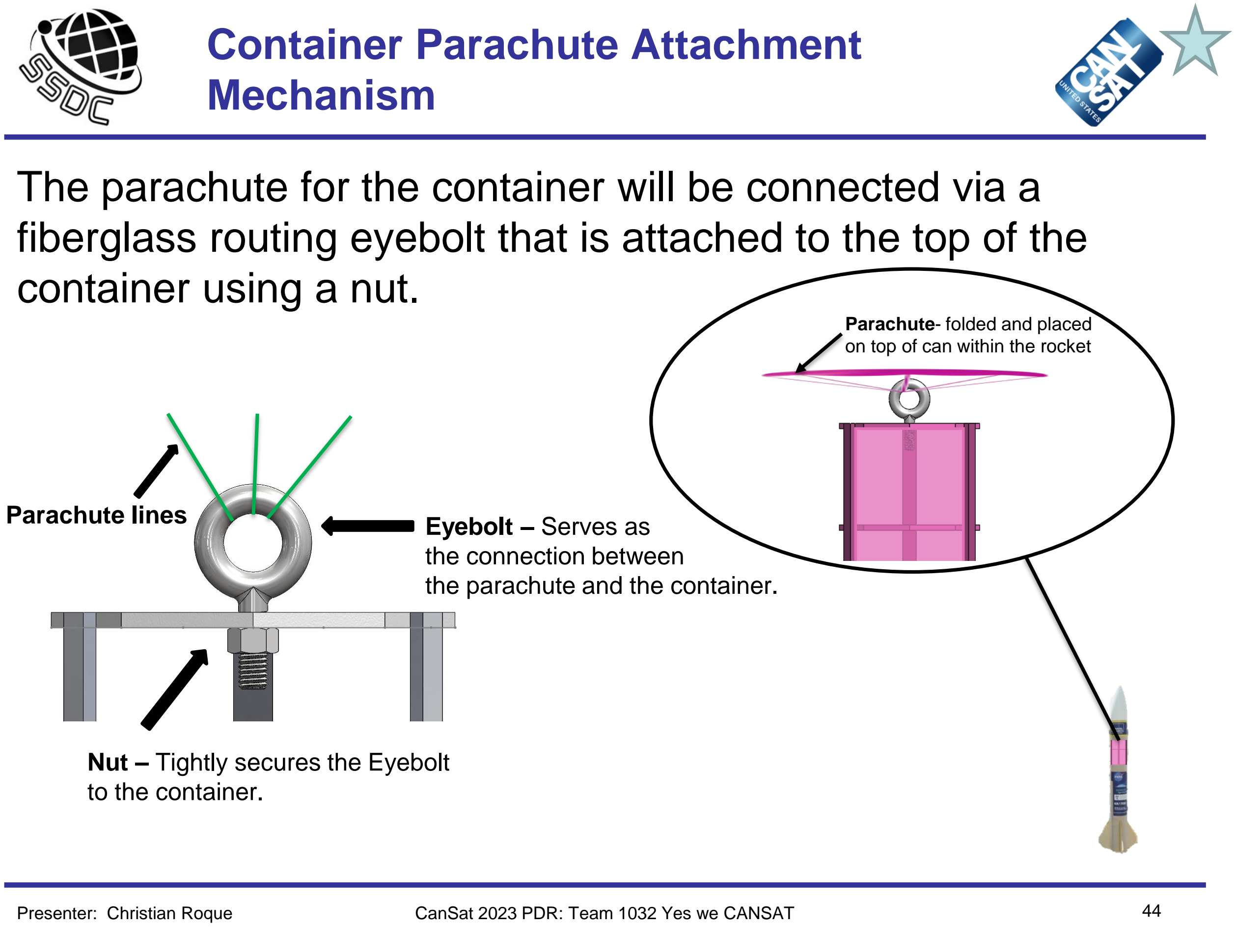
[picture p86: page 44]

(If You Want)

# The parachute for the container will be connected via a fiberglass routing eyebolt that is attached to the top of the

container using a nut.

Presenter: Christian Roque | CanSat 2023 PDR: Team 1032 Yes we CANSAT | 44

Parachute lines

Nut – Tightly secures the Eyebolt to the container.

Eyebolt – Serves as
the connection between
the parachute and the container.

Parachute- folded and placed on top of can within the rocket

(If You Want)

# Payload Mechanical Layout of Components Trade & Selection (1/2)

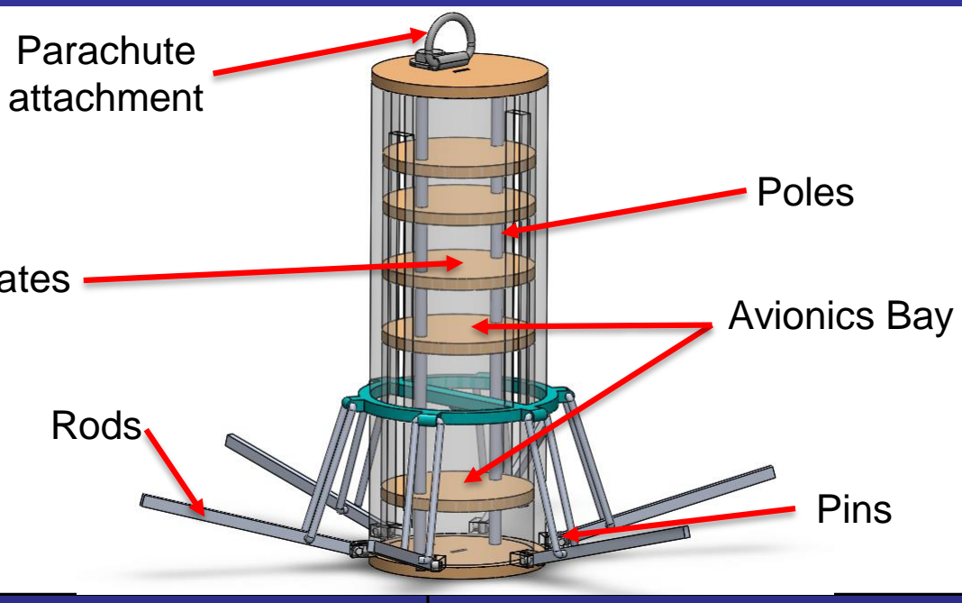
[picture p87: figure]
Rods; Poles; Parachute attachment; Avionics Bay

Presenter: Melissa Gonzalez Grospe | CanSat 2023 PDR: Team 1032 Yes we CANSAT | 45
Design | Description | Materials | Evaluation
Umbrella Mechanism | Overall cylindrical shape when compacted (in can). When released from can, rods fully extend to create a widened parabolic shape for the bottom half of the payload. All plates are circular. Top 2 plates are used for the parachute attachment and flag deployment device. The rest of the plates that make up the structure of the payload are reserved for electronics.
Plates – Wood
Poles – ABS Plastic
Rods – Aluminum
Pins – ABS Plastic
Parachute Attachment – Steel

Discarded

Plates

Pins

NOTE: Payload will be
released at 500 meters

(If You Want)

# Payload Mechanical Layout of Components Trade & Selection (2/2)

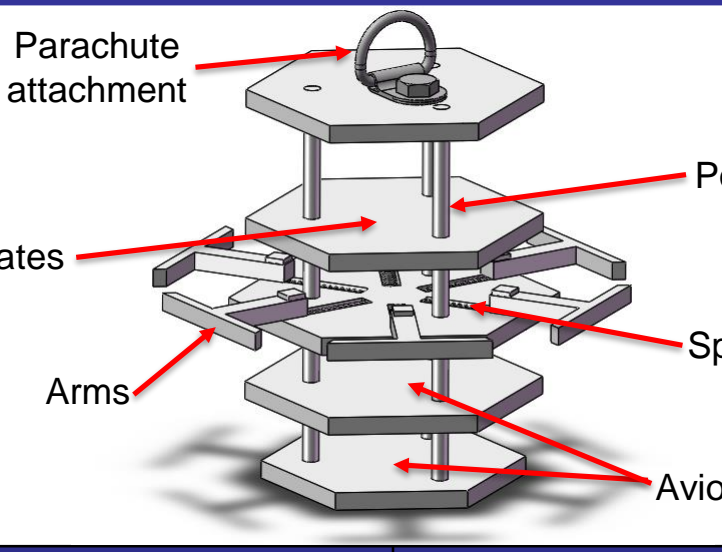
[picture p88: figure]
Arms; Parachute attachment

Presenter: Melissa Gonzalez Grospe | CanSat 2023 PDR: Team 1032 Yes we CANSAT | 46
Design | Description | Materials | Evaluation
Spring Loaded Hexagon | Overall hexagonal prism shape when compacted (in can). When released from can, arms expand to create an upside down truncated hexagonal pyramid for the bottom half of the payload. All plates are hexagonal. Bottom 2 plates are reserved for electrical components. Top 2 plates are used for the parachute attachment and flag deployment device.

Plates – ABS Plastic
Poles – Aluminum
Arms – ABS Plastic
Springs – Zinc Plated Steel Parachute Attachment – Steel

Selected, easier to
manufacture, lighter
in weight, structurally
practical

Plates

Springs

Poles

Avionics Bay

(If You Want)

# Payload Aerobraking Pre Deployment Configuration Trade & Selection

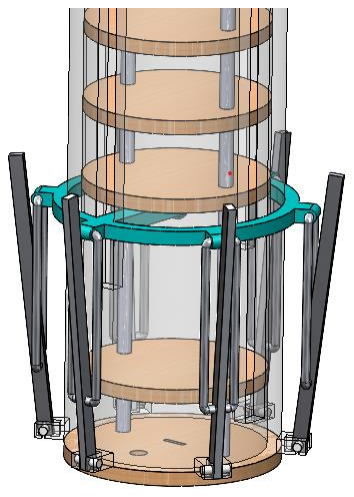
[picture p89: figure]
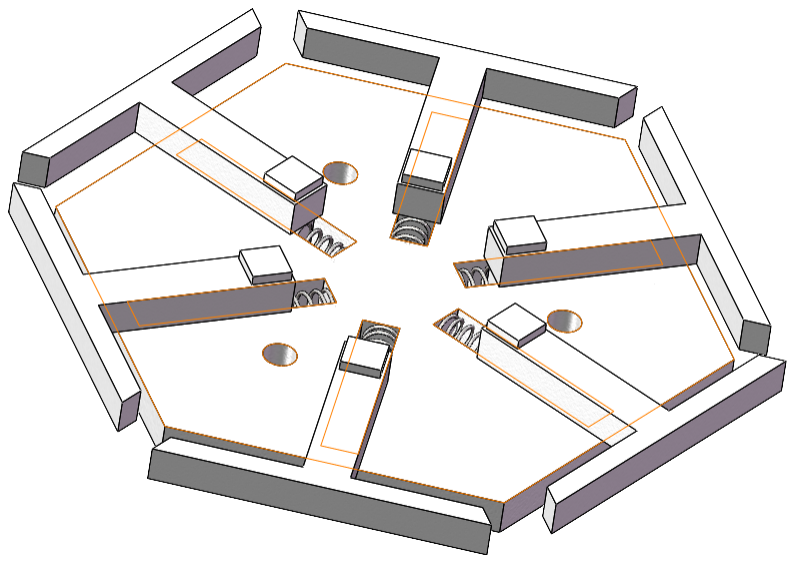
[picture p90: figure]

Presenter: Melissa Gonzalez Grospe | CanSat 2023 PDR: Team 1032 Yes we CANSAT | 47

Configuration A: Umbrella
Mechanism

Configuration B: Spring Loaded Mechanism

NOTE: Both
designs will be
compressed by the
interior wall of the
container during
pre-deployment
Configuration | Advantages | Disadvantages | Evaluation
Umbrella Mechanism | Only uses one spring More secure | Significantly heavier than configuration B Takes up large amount of space Difficult to manufacture | Discarded

Spring Loaded
Hexagon

Lightweight
Occupies small section of the CanSat
Uniform expansion

Large number of components required to hold it in place
More friction along the walls of the CanSat

Selected,
easier to
keep in
place

(If You Want)

# Payload Aerobraking Deployment Configuration Trade & Selection

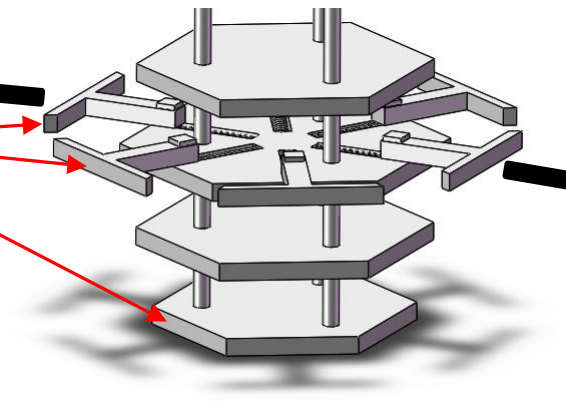
[picture p91: figure]
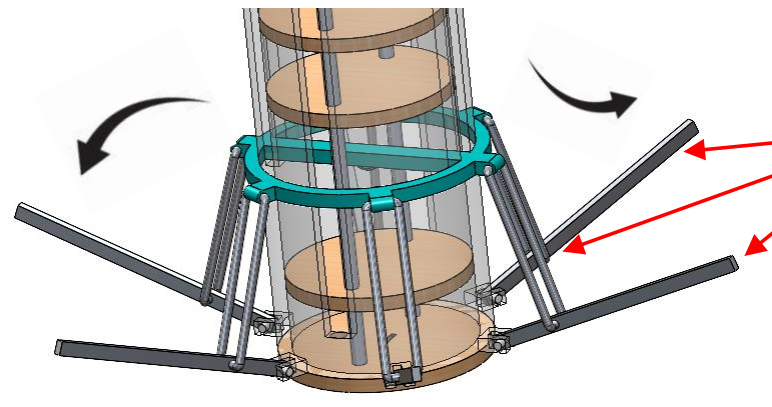
[picture p92: figure]

Presenter: Daniel Horton | CanSat 2023 PDR: Team 1032 Yes we CANSAT | 48
Configuration | Method | Identified Issues | Evaluation
Umbrella Mechanism | Upon release from can, the rods will extend fully, causing the implementation of the heat shield which acts as the aerobraking device. This creates an aerodynamic parabolic shape. | Entirely dependent on gravity, difficulty manufacturing the rods | Discarded
Spring Loaded Hexagon | Upon release from can, the spring loaded arms will be expanded, causing the implementation of the heat shield which acts as the aerobraking device. This creates an upside down truncated hexagonal pyramid shape. | Springs could go off inside the can, difficulty assembling the payload and inserting into can | Selected, smaller size makes it easier to deploy. Also, lightweight and easy to manufacture

Attach Heat
Shield material
(Mylar) here

(If You Want)

# Payload Parachute Deployment Configuration Trade & Selection

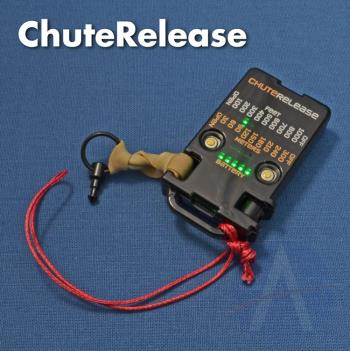
[picture p93: figure]
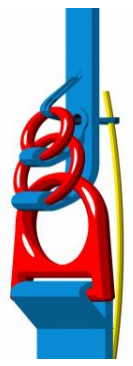
[picture p94: figure]

Presenter: Daniel Horton | CanSat 2023 PDR: Team 1032 Yes we CANSAT | 49
Method | Description | Identified Issues | Evaluation
Three Ring Release System | A cable is passed through this series of loops. Once the payload reaches the desired altitude, the chord will be released in a linear motion using a linear actuator. Releasing the chord will allow the parachute to naturally deploy | Requires a complex mechanical system. Additional linear actuator will add weight to the system. Linear actuator must be able to resist the shock of deployment. Requires extensive testing. | Discarded
Altimeter Chute Release | The parachute will sit atop the payload and be held together by the device using a chord and hook which are attached to the device. Once the desired altitude is reached, the device will release, and the parachute will be allowed to deploy naturally. | Device would add considerable weight to the system. Device would need to be purchased from a third-party and thus add to the expenses. | Selected, easier to secure and implement

Configuration A: Three Ring Release System

Configuration B: Altimeter Chute release

(If You Want)

# Payload Uprighting Configuration Trade & Selection

Presenter: Daniel Horton | CanSat 2023 PDR: Team 1032 Yes we CANSAT | 50
Method | Benefits | Identified Issues | Evaluation
Active Uprighting System | Much better chance of payload being upright, | Additional subsystem to implement, which would add weight, complexity, and issues with room for all components | Discarded
Passive Uprighting system | Would not require an additional subsystem | Not a guarantee for the payload to land upright, requires extensive testing | Selected, easier to manufacture, less weight added to the system

(If You Want) | Container Mass Budget
Presenter: Savari Datta | CanSat 2023 PDR: Team 1032 Yes we CANSAT | 51
Sensor | Quantity | Weight (g) | Source
Adafruit BMP280 | 1 | 1.3 | Actual from Datasheet
Arduino Nano | 1 | 7 | Actual from Datasheet
2032 Cell Batteries | 2 | 6.2 (3.1 each) | Actual from Datasheet
Aluminum Supports | 3 | 124.9 | Actual from Datasheet
Aluminum Nut | 1 | 0.5 | Actual from Datasheet
Eyebolt | 1 | 2.4 | Actual from Datasheet
Can Platforms | 3 | 140.3 | Estimate
JB Weld Plastic Bonder | 1 | 2 | Estimate
Linear Actuator | 1 | 15 | Actual from Datasheet
Linear Actuator Ring | 1 | 0.2 | Actual from Datasheet
Plastic Coupling Nuts | 4 | 0.4 | Actual from Datasheet
PCB Screws | 4 | 0.1 | Actual from Datasheet

Total Mass: 300.3g

(If You Want) | Payload Mass Budget (1/3)
Presenter: Savari Datta | CanSat 2023 PDR: Team 1032 Yes we CANSAT | 52
Sensor | Quantity | Weight (g) | Source
Adafruit BMP280 | 1 | 1.3 | Actual from Datasheet
BNO-055 | 1 | 3 | Actual from Datasheet
Adafruit Ultimate | 1 | 8.5 | Actual from Datasheet
Raspberry Pi Pico | 1 | 3 | Actual from Datasheet
ANT-900-RP-2-A | 1 | 5 | Estimate
Arducam Mini | 1 | 20 | Actual from Datasheet
Mirco SD cards | 1 | 1 | Actual from Datasheet
Micro SD Readers | 1 | 3.4 | Actual from Datasheet
XBEE Pro 900 Mhz Radio | 1 | 5 | Actual from Datasheet
2032 Cell Batteries | 2 | 6.2 (3.1 each) | Actual from Datasheet

(If You Want) | Payload Mass Budget (2/3)
Presenter: Savari Datta | CanSat 2023 PDR: Team 1032 Yes we CANSAT | 53
Sensor | Quantity | Weight (g) | Source
Springs | 6 | 0.3 | Actual from Datasheet
Heatshield Arms | 6 | 14.1 | Estimate
Payload Rods | 3 | 19.5 | Estimate
Platforms | 5 | 138.3 | Estimate
Flag Release | 1 | 6.84 | Estimate
Steel Tape | 1 | 1 | Estimate
Super Lube | 1 | 1 | Estimate
Clock Spring | 1 | 7.8 | Actual from Datasheet
Screw | 1 | 0.7 | Actual from Datasheet
Nut | 1 | 0.5 | Actual from Datasheet
Servo Motor | 1 | 9 | Actual from Datasheet

(If You Want) | Payload Mass Budget (3/3)
Presenter: Savari Datta | CanSat 2023 PDR: Team 1032 Yes we CANSAT | 54
Sensor | Quantity | Weight (g) | Source
Servo Motor | 1 | 9 | Actual from Datasheet
Mylar Fabric | 1 | 112.1 | Estimate
Parachute | 1 | 28 | Estimate

Total Mass: 380.9 g

# Communication and Data Handling (CDH) Subsystem Design

# Max Epstein, Yashas Shivaram

CanSat 2023 PDR: Team 1032 Yes we CANSAT | 55

# Payload Command Data Handler (CDH) Overview

Presenter: Yashas Shivaram | CanSat 2023 PDR: Team 1032 Yes we CANSAT | 56
Device Type | Model | Purpose
Processor & Memory | Raspberry Pi Pico | Facilitate data storage, sensing, communication
Real-Time Clock | Adafruit Ultimate Breakout v3 GPS Module | Keep track of times for data & calculation purposes
Antenna | ANT-900-RP-2-A | Transmit/receive data from radio/processor configuration
Radio | XBEE-PRO 900HP | Communicate between antennae & processors

(If You Want)

# Payload Processor & Memory Trade & Selection


Presenter: Yashas Shivaram | CanSat 2023 PDR: Team 1032 Yes we CANSAT | 57
Processor | Boot time(s) | Speed (Mhz) | Memory (KB) | Weight (g) | Dimension (mm) | Voltage Input (V) | Ports
Arduino Nano | 8 - 10 | 16 | 32 | 7 | 18 x 45 | 7 - 12 | Analog Input - 8 PWM Output - 6 I2C I/O - 1 SPI - 1 DAC Output - 0
Raspberry pi Pico | 0.5 | 125 | 264 | 3 | 51.3x21 | 1.8 – 5.5 | Analog Input - 4 PWM Output - 8 I2C I/O – 1 SPI – 1 DAC Output - 1
Teensy 3.2 | 5 | 16 | 256 | 4.8 | 18 x 36 | 5 | Analog Input - 25 PWM Output - 22 I2C I/O - 4 SPI - 3 DAC Output - 2
Selection | Reasoning for selection
Raspberry Pi Pico | - Compact size - Compatibility with camera/Familiarity - Availability

(If You Want) | Payload Real-Time Clock


Presenter: Yashas Shivaram | CanSat 2023 PDR: Team 1032 Yes we CANSAT | 58
Selection | Reasoning for selection
Adafruit Ultimate GPS Breakout | - Already part of the board - GPS Module will have an independent battery backup - No additional weight, size, or circuitry required
Real-Time Clock Keeper | Tolerance Reset | Interface | Cost ($)
Microchip MCP7940M-I/P | Real-Time clock continues keeping time in the event of a reset | I2C | 0.75
Arduino Ultimate Breakout v3 | Real-Time clock continues keeping time in the event of a reset | Internal to GPS | 0.00

(If You Want) | Payload Antenna Trade & Selection

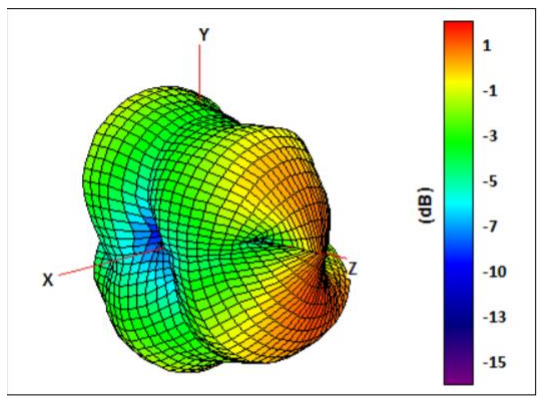
[picture p95: figure]
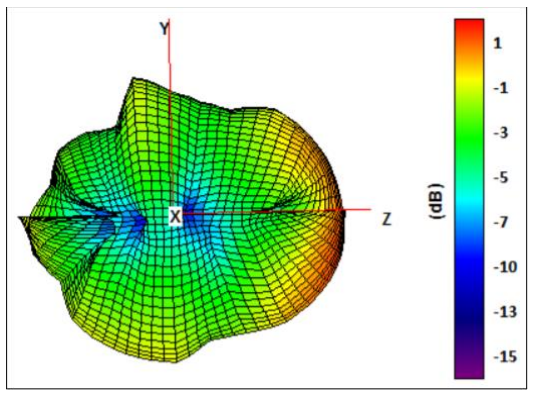
[picture p96: figure]
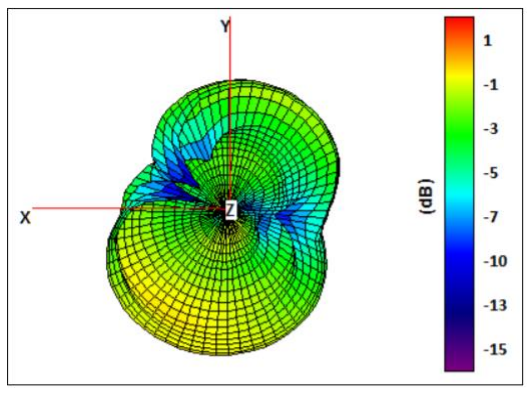
[picture p97: figure]

Presenter: Yashas Shivaram | CanSat 2023 PDR: Team 1032 Yes we CANSAT | 59
Name | Frequency Range (GHz) | Antenna (mm) Length of | Gain (dBi) | Polarization | Connection Type | Weight (g)
ANT-900-RP-2-A | .880-.960 | 115 | 2.1 | (Linear) Vertical | SMA | 11
Taoglas FXP290 915 MHz | .902-.928 | 100 | 1.5 | Linear | U.FL | 1.5
Selection | Reasoning for selection
ANT-900-RP-2-A | - In accepted frequency range - Compatible with selected radio - Relatively small size

(If You Want) | Payload Radio Configuration
Presenter: Yashas Shivaram | CanSat 2023 PDR: Team 1032 Yes we CANSAT | 60
Name | Frequency Range (GHz) | Outside Range (km) | Antenna Type | Weight (g) | Cost ($)
XBEE-PRO 900HP | .902 - .928 | 6.5 | RPSMSA | 6.9 | 68
XBee S2C 802.15.4 | 2.4 | 1.2 | Wire | 5 | 30
Selection | Reasoning for selection
XBEE-PRO 900HP | - Operates on accepted frequency - Excellent outside range

NETID/PANID – 1032

Transmission Control

- Data will be continuously sent at 1 Hz during all stages of flight
- Transmission will be handled by FSW, starting on power on and ending once the container and payload have landed

# (If You Want) Payload Telemetry Format

- Transmitted Data will be saved to a .csv file on ground station.

## - Data Transmitted: - To GCS at 1 Hz packet transmission rate:

Payload sensor readings (Air pressure/temperature, mission time,

## GPS time, coordinates, power supply voltage, tilt, altitude, and various states) How is the data formatted? -Payload-to-GCS:

-<TEAM_ID>,< MISSION_TIME>, <PACKET_COUNT>, <MODE>,
<STATE>, <ALTITUDE>,<HS_DEPLOYED>,<PC_DEPLOYED>,<MAST_RASIED> <TEMP>, <VOLTAGE>, <PRESSURE>,< GPS_TIME>, <GPS_ALTITUDE>, <GPS_LATITUDE>, <GPS_LONGITUDE>, <GPS_SATS>, <TILT_X>,<TILT_Y>, <CMD_ECHO>
- Example:
- <1063>, <13:35:59>, <25>, <F>, <LAUNCH_WAIT>,<N>,<N>,<N>,<25.3>,<8.3>,<230>, <13:35:35>,<25>,<150.0258>,<168.6765>,<58>,<5.02>,<3.05><CXON>
Presenter: Max Epstein | CanSat 2023 PDR: Team 1032 Yes we CANSAT | 61

# (If You Want) Payload Telemetry Format

62

Telemetry Field | Purpose | Relayed From:
<TEAM_ID> | Team ID number (1063)
<MISSION_TIME> | UTC time from RST=0 in 1st software state (hh:mm:ss)
<PACKET_COUNT> | # of packets transmitted across all devices
<MODE> | 'F' = Flight (default) mode, 'S' = Simulation mode
<STATE> | Software State (STARTUP, DESCENT, etc.)
<ALTITUDE> | Altitude in meters relative to ground level (+/- 0.1 m)
<HS_DEPLOAYED> | ‘P’ if the probe has been deployed, ‘N’ if not
<PC_DEPLOAYED> | ‘C’ if the probe parachute has been deployed, ‘N’ if not
<MAST_RAISED> | ‘M’ if the flag has been raised, ‘N’ if not
<TEMP> | The temperature in degrees Celsius (+/- 0.1C)

Payload

Presenter: Max Epstein | CanSat 2023 PDR: Team 1032 Yes we CANSAT

# (If You Want) Payload Telemetry Format

63

Telemetry Field | Purpose | Relayed From:
<PRESSURE> | The air pressure in kPa (+/- 0.1 kPa)
<VOLTAGE> | Voltage reading of Container power bus (+/- 0.1 V)
<GPS_TIME> | UTC time generated from GPS (hh:mm:ss) (+/- 1 sec)
<GPS_LATITUDE> | GPS latitude coordinate in decimal degrees (+/- 0.0001 degrees North)
<GPS_LONGITUDE> | GPS longitude coordinate in decimal degrees (+/-0.0001 degrees West)
<GPS_ALTITUDE> | GPS altitude coordinate in decimal degrees (+/- 0.1 m from sea level)
<GPS_SATS> | # of satellites being tracked by GPS
<TILT_X> | The angle of the payload in the x direction in degrees (+/- 0.01)
<TILT_Y> | The angle of the payload in the y direction in degrees (+/- 0.01)
<CMD_ECHO> | The last command received and processed by the payload

Payload

Presenter: Max Epstein | CanSat 2023 PDR: Team 1032 Yes we CANSAT

(If You Want) | Payload Command Formats
CanSat 2023 PDR: Team 1032 Yes we CANSAT | 64

CX - Container Telemetry On/Off Command

CMD,<TEAM_ID>, CX, <ON_OFF>

CMD & CX | Static Text
<TEAM_ID> | Assigned Team Identification
<ON_OFF> | ON-activates Container transmissions OFF- turns off transmissions

Example: CMD,1032,CX,ON

ST - Set Time

CMD,<TEAM_ID>, ST, <UTC_TIME>

CMD & ST | Static Text
<TEAM_ID> | Assigned Team Identification
<UTC_TIME> | UTC time in the format hh:mm:ss

Example: CMD,1032,ST,13:35:59

SIM - Simulation Mode Control Command

CMD,<TEAM_ID>, SIM, <MODE>

CMD & SIM | Static Text
<TEAM_ID> | Assigned Team Identification
<MODE> | ‘ENABLE’ to enable -‘ACTIVATE’ to activate-'DISABLE’ both disables and deactivates -> simulation mode.

Example: CMD,1032,SIM,ACTIVATE

SIMP - Simulated Pressure Data

CMD,<TEAM_ID>, SIMP, <PRESSURE>

CMD & SIMP | Static Text
<TEAM_ID> | Assigned Team Identification
<PRESSURE> | simulated atmospheric pressure data in units of pascals with a resolution of one Pascal.

Example: CMD,1032,SIMP,101325

Presenter: Max Epstein

# Electrical Power Subsystem (EPS) Design

# Paolo D’Alessandro

CanSat 2023 PDR: Team 1032 Yes we CANSAT | 65

(If You Want) | EPS Overview

3.3V Battery; Switch; 5V Regulator; 3.3V Regulator; 5V Bus; 3.3V Bus

Presenter: Paolo D’Alessandro | CanSat 2023 PDR: Team 1032 Yes we CANSAT | 66

# (If You Want) Payload Electrical Block Diagram

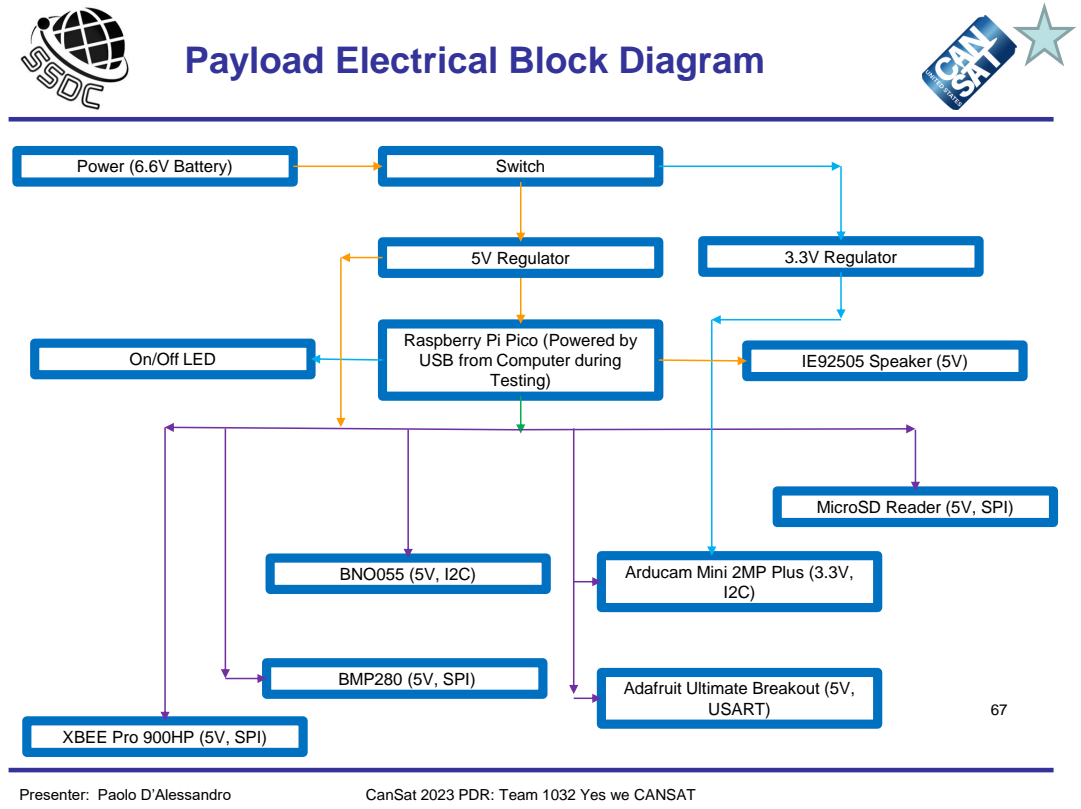
[picture p98: page 67]
Testing); BNO055 (5V, I2C); BMP280 (5V, SPI); Power (6.6V Battery); Switch; USART); 5V Regulator; On/Off LED; IE92505 Speaker (5V); 3.3V Regulator

Raspberry Pi Pico (Powered by
USB from Computer during

MicroSD Reader (5V, SPI)

Arducam Mini 2MP Plus (3.3V,

Adafruit Ultimate Breakout (5V,

XBEE Pro 900HP (5V, SPI)

Presenter: Paolo D’Alessandro

CanSat 2023 PDR: Team 1032 Yes we CANSAT

(If You Want) | Payload Power Trade & Selection


Presenter: Paolo D’Alessandro | CanSat 2023 PDR: Team 1032 Yes we CANSAT | 68
Type | Battery | Voltage | Capacity | Weight | Qty. Needed | Total Voltage | Total Weight
Alkaline Industrial Battery | 9V | 9V | 3.6mAh | 46g | 1 | 9V | 46g
Lithium LiCB | CR2032 | 3.3V | 236mAh | 3.1g | 2 | 6.6V | 6.2g

Battery Configuration

Two CR2032 in series to provide ~6V

Selection | Reason for Selection
Lithium LiCB CR2032 | - Smaller weight and easily scalable for more power

(If You Want) | Payload Power Budget
Presenter: Paolo D’Alessandro | CanSat 2023 PDR: Team 1032 Yes we CANSAT | 69
Component | Voltage (V) | Power per Unit (W) | Duty Cycle (%) | Power Consumption (Wh) | Source
Raspberry Pi Pico (Microcontroller) | 9V | .1406 | 100 | 0.1406 | Datasheet
Adafruit Ultimate Breakout (GPS) | 5V | .1 | 100 | .1 | Datasheet
BMP280 (Air Temperature/Pressure) | 5V | 0.00025 | 100 | 0.000025 | Datasheet
IE092505-1 (Sound Alert) | 5V | .03 | 100 | 50m | Datasheet
Xbee Pro 900 HP (Radio Module) | 5V | .0.95 | 100 | .95 | Datasheet
LED Light (Lighting Alert) | 2.2V | 0.044 | 100 | 0.044 | Datasheet
BNO 055 (Temp/Rotational Sensor) | 1.7-3.6V | 0.0123 | 100 | 0.00155 | Datasheet

# Flight Software (FSW) Design

# Max Epstein

CanSat 2023 PDR: Team 1032 Yes we CANSAT | 70

(If You Want) | FSW Overview (1/2)
Presenter: Max Epstein | CanSat 2023 PDR: Team 1032 Yes we CANSAT | 71
Boot up | Calibrate Sensors

Start
communication
between
payload and
GCS

Process live
altitude data

Start
Payload
release

Start payload
parachute
release

Detect
payload
landing

Terminate
telemetry

Raise Mast

## Flowchart

Initiate audio
beacon

(If You Want) | FSW Overview (2/2)
Presenter: Max Epstein | CanSat 2023 PDR: Team 1032 Yes we CANSAT | 72
Programming Languages | Python
Development Environments | Visual Studio Code
FSW Tasks | - Boot up and collect sensor data in the correct units required by CanSat. - Communicate telemetry from the payload and container to the GCS to store data. - Keep track of altitude and release the payload and parachute when needed. - Trigger audio beacon after landing.
Payload FSW | - Payload communication - In charge of collecting data with sensors - Contains temperature sensor, pressure sensor, rotational sensor, camera

(If You Want) | Payload FSW State Diagram (1/3)


Presenter: Max Epstein | CanSat 2023 PDR: Team 1032 Yes we CANSAT | 73

(If You Want) | Payload FSW State Diagram (2/3)

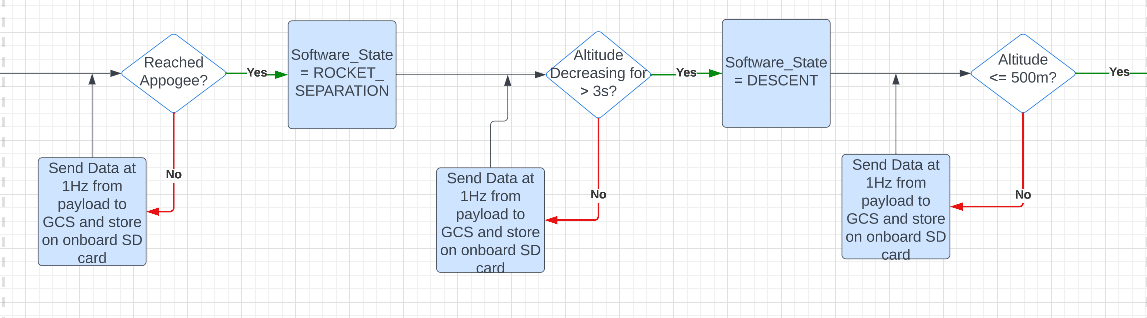
[picture p99: figure]

Presenter: Max Epstein | CanSat 2023 PDR: Team 1032 Yes we CANSAT | 74

(If You Want) | Payload FSW State Diagram (3/3)


Presenter: Max Epstein | CanSat 2023 PDR: Team 1032 Yes we CANSAT | 75

(If You Want) | Payload FSW State Diagram
Presenter: Max Epstein | CanSat 2023 PDR: Team 1032 Yes we CANSAT | 76

## FSW Recovery from Reset

## What is used to recover: - Mission Time - GPS Time - Software State - Altitude

## Causes that call for reset: - Power loss (power supply) - Physical damage - Processor failure

# (If You Want) Simulation Mode Software

## - Sensor changes - All air pressure sensors disabled

## - Simulation mode commands - <MODE> switches from 'F' (Flight) to 'S' (Simulation)

## - How is simulated sensor data substituted with real data? - External data from text file fed into certain fields instead of air pressure sensor readings

| • <ALTITUDE>, <PRESSURE>

## - All other sensor readings & telemetry remain the same

Presenter: Max Epstein | CanSat 2023 PDR: Team 1032 Yes we CANSAT | 77

# (If You Want) Software Development Plan (1/2)

## Prototyping and Prototyping Environments - Environment in Visual Studio Code and Arduino IDE - Modular code parts

## Development Team - Max Epstein - Dylan Falzone - Yashas Shivaram - Paolo D’Alessandro

## Test Methodology

- Simulation mode with varying datasets.

## - Freefall sensor testing

Presenter: Max Epstein | CanSat 2023 PDR: Team 1032 Yes we CANSAT | 78

(If You Want) | Software Development Plan (2/2)
Presenter: Max Epstein | CanSat 2023 PDR: Team 1032 Yes we CANSAT | 79
Subsystem | Development Sequence
Sensors | i. Sensor trade and selection compare and select the best ii. Program each individual sensor in Arduino iii. Integrate and conglomerate all programs, make sure it still functions
Xbee Radio | i. Configure and test point to point communication for the radio (controller and GCS port) ii. Integrate sensors with Xbee for data transmission
Flight Control | i. Program feedback system with servos connected to flight mechanisms
Release Mechanisms | i. Program release mechanisms such as linear actuators
Software State | i. Use the data from sensors to change the states
Audio Beacon | i. Program locator audio beacon
Integration | i. Integrate all software subsystem and ensure 1Hz data transmission from payload. Also, to make sure the software states match up with what is occurring.

# Ground Control System (GCS) Design

# Dylan Falzone, Max Epstein

CanSat 2023 PDR: Team 1032 Yes we CANSAT | 80

(If You Want) | GCS Overview


Presenter: Dylan Falzone | CanSat 2023 PDR: Team 1032 Yes we CANSAT | 81

# Flight Software

(If You Want) | GCS Design


Presenter: Dylan Falzone | CanSat 2023 PDR: Team 1032 Yes we CANSAT | 82

Specifications

Laptop Battery | 4 Hours
Overheating Mitigation | Umbrella & Laptop Cooler
Auto update Mitigation | Disable Auto-Update

(If You Want) | GCS Antenna Trade & Selection

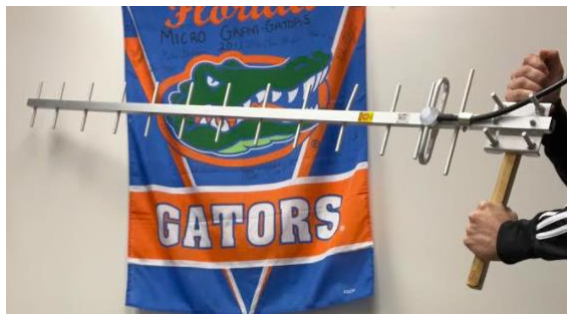
[picture p100: figure]
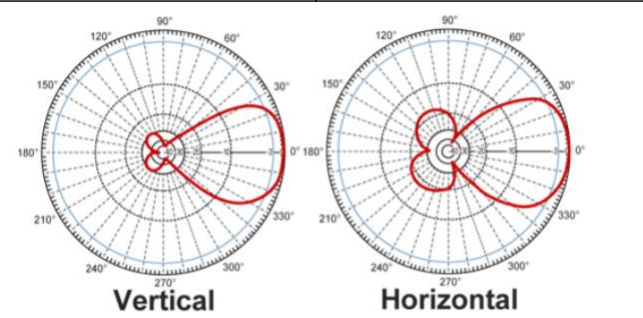
[picture p101: figure]

Presenter: Dylan Falzone | CanSat 2023 PDR: Team 1032 Yes we CANSAT | 83
Name | Frequency Range (GHz) | Antenna (mm) Length of | Gain (dBi) | Polarization | Connectio n Type | Weight (g) | Cost ($)
Right-Angle Mini GSM | .85-2.1 | 57 | 2 | (Linear) Vertical | Right Angle SMA | 8 | 4.95
TL-Dipole Swivel Antenna | 2.4 | 200 | 5 | (Linear) Vertical | RP-SMA | 30 | 8.95
900 MHz 14 dBi Al Yagi Antenna | .90-.928 | 1422 | 14 | Linear | N-Female | 680 | 72.32
Selection | Reasoning for selection
Yagi Antenna | - Gain strength immensely stronger than the other antennas - Larger antenna - Ideal frequency range - Handheld, easy to maneuver

(If You Want) | GCS Software (1/3)
Presenter: Max Epstein | CanSat 2023 PDR: Team 1032 Yes we CANSAT | 84

Software Packages:
- Python 3.9.7 - Computational environment of choice
- XCTU – XBee Program Software
- XBEE Python Library – real time access to XBEE via USB interface
- Matplotlib Python Library – real time plotting and data manipulation
- PySimpleGUI Python Library – visual design layout and manipulation
- Pandas Python Library – real time data collection and .csv file status

Command Software and Interface:
- Commands can be sent from the Ground Control Station to the CanSat via command.
- The GCS uses the XBEE Python Library to access the XBEE receiver through the USB interface.

Telemetry Data Recording:
- Telemetry will be saved in a .csv file without manipulation after being read via USB interface.
- .csv data will be analyzed in python and presented via GUI and saved in file.

CSV File Generation:
- .csv file will be generated in GCS Python software for payload and data will be continuously added to the created file as it arrives in packets to GCS.

# (If You Want) GCS Software (2/3)

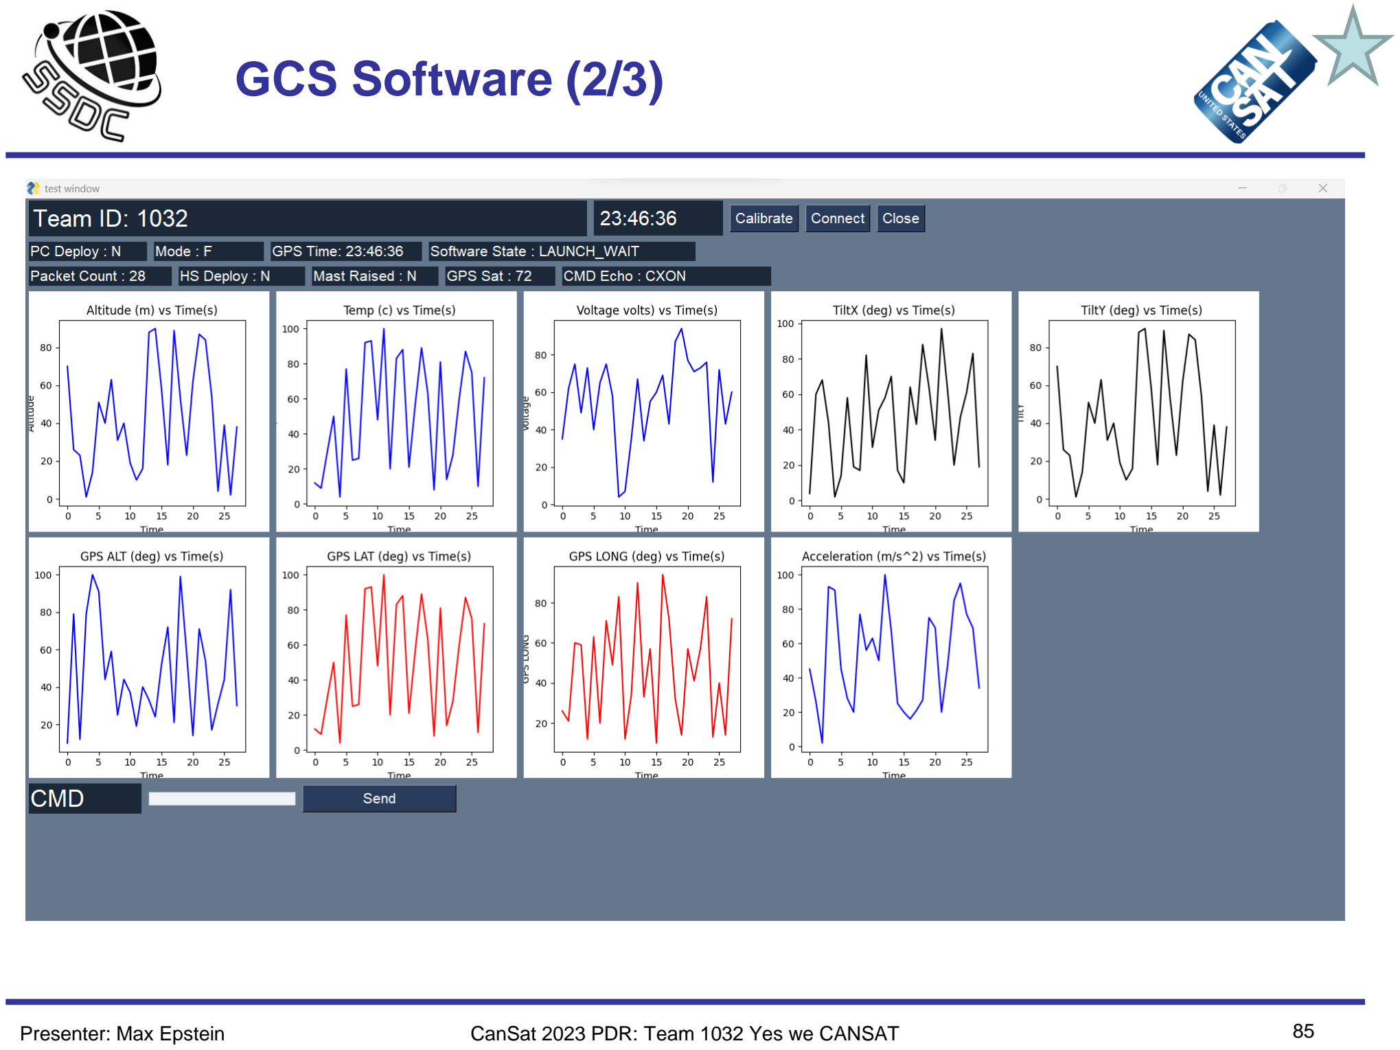
[picture p102: page 85]

Presenter: Max Epstein | CanSat 2023 PDR: Team 1032 Yes we CANSAT | 85

(If You Want) | GCS Software (3/3)


Presenter: Max Epstein | CanSat 2023 PDR: Team 1032 Yes we CANSAT | 86

# CanSat Integration and Test

# Jordi Rey, Yashas Shivaram

CanSat 2023 PDR: Team 1032 Yes we CANSAT | 87

(If You Want)

# CanSat Integration and Test Overview

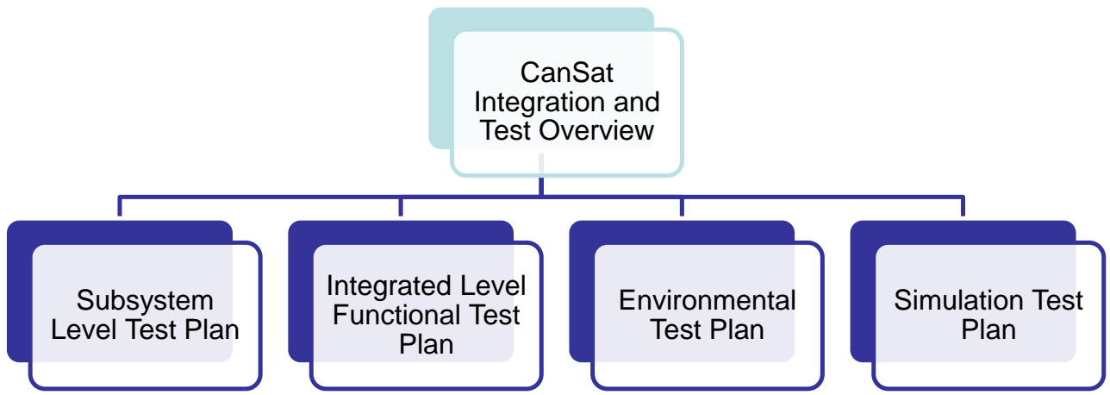
[picture p103: figure]
CanSat Integration and Test Overview; Subsystem Level Test Plan; Integrated Level Functional Test Plan; Environmental Test Plan; Simulation Test Plan

Presenter: Yashas Shivaram | CanSat 2023 PDR: Team 1032 Yes we CANSAT | 88

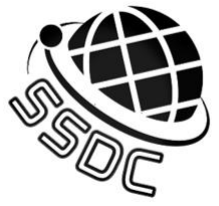
[picture p104: figure]

(If You Want) | Subsystem Level Testing Plan (1/2)
Presenter: Yashas Shivaram | CanSat 2023 PDR: Team 1032 Yes we CANSAT | 89

Subsystem Level Testing

Sensors | - Pressure sensor tests - Temperature sensor tests - GPS location & time tests - Rotational Sensors tests - Camera recording and saving video tests
CDH | - Processor clock speed tests - EEPROM storage size tests - EEPROM read/write speed tests
EPS | - Battery voltage readings - Impedance tests on each component - Battery power output & tolerance tests
Radio Communications | - XBEE radio receiver/sender tests - Antenna signal quality tests - Packet receival and transmission tests

(If You Want) | Subsystem Level Testing Plan (2/2)
Presenter: Yashas Shivaram | CanSat 2023 PDR: Team 1032 Yes we CANSAT | 90

Subsystem Level Testing

FSW | - Data live graph generation tests - Simulation mode tests - CSV data saving & handling - Software states testing
Mechanical | - Container & probe structural tests - Probe deployment tests - Probe upright testing - Avionics bay structural integrity tests - Parachute deployment release tests - Probe stability control tests - Flag raising test
Descent Control | - Parachute Drogue tests - Parachute reefing tests - Parachute deployment tests - Aerobraking device testing

(If You Want) | Integrated Level Functional Test Plan
Presenter: Jordi Rey | CanSat 2023 PDR: Team 1032 Yes we CANSAT | 91

Testing Plan

Decent Testing | - PID Controller payload descent rate tests
Communications | - Telemetry transmission and retrieval tests - Communication between GCS and Payload
Mechanisms | - Payload release mechanism tests - Payload stability control tests - Aerobrake release mechanism tests - Flag deployment mechanism tests - Payload parachute release mechanism tests
Deployment | - Payload deployment tests are various altitudes - Payload parachute deployments tests at various altitudes - Aerobrake deployments tests are various altitudes - Linear actuator integration with altitude sensor readings

(If You Want) | Environmental Test Plan (1/2)
Presenter: Jordi Rey | CanSat 2023 PDR: Team 1032 Yes we CANSAT | 92

## Drop Test

## - Verify that all structures can survive 15 Gs of launch acceleration and 30 Gs of shock - Verify that the container can survive deployment from rocket - Verify that payload remains in stowed state - Verify that component and battery mounts can withstand applied forces

## Thermal Test

## - Verify the CanSat can operate in a hot environment without materials and/or components becoming functionally compromised

## Vibration Test

## - Verify the structural integrity of all mounts and connections within the CanSat - Verify that payload remains in stowed state

## Fit Check

## - Verify that the CanSat and container fits within rocket to minimize deployment failure

Vacuum Test | • Verify deployment operations of the payload

(If You Want) | Environmental Test Plan (2/2)
Presenter: Jordi Rey | CanSat 2023 PDR: Team 1032 Yes we CANSAT | 93

Drop Test

- Plan: Secure the CanSat to testing rig with non-stretch cord, release the CanSat from 61 cm and allow it to freefall, inspect CanSat and payloads for damage, if there was no damage then run a functional test.

Thermal Test

- Plan: Place the CanSat in an insulating cooler with a hair dryer, use a remote thermometer to monitor temperature, turn on the CanSat, turn off the heat source once internal temperatures reach 60C and turn on heat sources when temperature reaches 55C. Main this for 2 hours. With heat source off, visually inspect and functionally test CanSat to verify operational integrity survived thermal exposure.
Vibration Test
- Plan: Attach the CanSat to a random orbital sander and power it up to full speed, wait 5 seconds after the sander is at full speed then power it off, repeat the process 5 more times. Remove CanSat from fixture and visually inspect and functionally test CanSat to verify operation integrity. Verify accelerometer data is still being collected.

Fit Check

- Plan: Construct a prototype of the rocket cylinder wall, place the container with the payloads properly stowed inside of the prototype and check for proper fit as well as the ability to securely deploy.

Vacuum Test

- Plan: Construct a vacuum chamber using a bucket and a vacuum cleaner. Suspend fully configured and powered CanSat within the vacuum chamber and turn on the vacuum. Monitor telemetry and stop the vacuum once peak altitude has been reached. Let air enter vacuum chamber slowly and monitor operation of CanSat. Collect and save telemetry. Save telemetry for judge reviewal.

(If You Want) | Simulation Test Plan
Presenter: Jordi Rey | CanSat 2023 PDR: Team 1032 Yes we CANSAT | 94

## How simulation works

## - After configuration, once the SIM ENABLE and SIM ACTIVATE commands are ran, simulation mode will

run.

## - The ground station will transmit pressure data from a

csv file at 1Hz intervals to the payload.

## - The flight software will determine altitude using radio

linked values instead of live sensor data.

## - The flight software will detect the launch and

release payload and parachute at respective altitudes.

## - Lastly, the mast will be raised and the audio beacon will begin once landing is detected

## What parts are tested

- The configuration and echoing of commands.
- The calculation of altitude with fed data from the CSV.

## - The deployment of payload parachute, mast raise, and

trigger of audio beacon.

## - Payload video is saved and pointing in the correct

direction.

# Mission Operations & Analysis

# Jordi Rey

CanSat 2023 PDR: Team 1032 Yes we CANSAT | 95

(If You Want)

# Overview of Mission Sequence of Events (1/2)

# Flowchart


Presenter: Jordi Rey | CanSat 2023 PDR: Team 1032 Yes we CANSAT | 96

(If You Want)

# Overview of Mission Sequence of Events (2/2)

# Roles & Responsibilities

## - Mission Control Officer – Savari Datta - Ground Station Crew – Christian Roque, Max Epstein, and Yashas Shivaram - Recovery Crew – Jordi Rey and Daniel Horton - CanSat Crew – Paolo D'Alessandro, Jovana Markovic, Melissa Gonzalez Grospe, Dylan Falzone, Savari Datta, Jordi Rey

# Antenna Construction & Ground System Setup

## - Handheld ground station antenna will be mounted to wood to be easily handled and aimed before competition date - Ground system will be setup by Ground Station Crew, this includes the adapters necessary for the ground station antenna and XBEE radio

Presenter: Jordi Rey | CanSat 2023 PDR: Team 1032 Yes we CANSAT | 97

(If You Want)

# Mission Operations Manual Development Plan

## Mission Operations Manual Outline: CGS Configuration: - Indicates the status of the GCS, antennas, and flight software for final pre-flight

checks.

## CanSat Preparation and Assembly: - Indicates the assembly of the CanSat, damage inspection, and assembly of components CanSat-Rocket Integration: - Indicates a final checklist and procedure for rocket clearances and assembly

inspections.

## Launch Preparation: - Provided by CanSat competition.

## Launch Procedure: - Provided by CanSat competition.

## Removal Procedure:

- Provided by CanSat competition.
Presenter: Jordi Rey | CanSat 2023 PDR: Team 1032 Yes we CANSAT | 98

# (If You Want) CanSat Location and Recovery

# Recovery Crew will be responsible for container and payload recovery

## - Container & Parachute will be a bright pink color making them

easier to identify and locate.

## - Most recently logged position on GPS will be used to more accurately locate the payload

## - Contact information and return address labels will be on both the container and the payload

Presenter: Jordi Rey | CanSat 2023 PDR: Team 1032 Yes we CANSAT | 99

# Requirements Compliance

# Savari Datta

CanSat 2023 PDR: Team 1032 Yes we CANSAT | 100

# (If You Want) Requirements Compliance Overview

## - Yes we CANSAT’s project complies with the requirements of the CanSat 2023 mission

## - The requirement compliance was measure using three conditions which are

detailed below: Full Compliance, Partial Compliance, and No Compliance.

Presenter: Savari Datta | CanSat 2023 PDR: Team 1032 Yes we CANSAT | 101
Full Compliance | The CanSat project complies 50/61 mission requirements
Partial Compliance | There are 8 requirements partially satisfied by our CanSat. This means that the requirement is technically met but will require further analysis and testing for finalization. The mass will meet requirements after the addition of the “No Compliance” components
No Compliance | There are 3 requirements our current build does not comply to. Modifications are currently being planned out to add access to the switch and wrap everything so it is secure

(If You Want) | Requirements Compliance
Presenter: Savari Datta | CanSat 2023 PDR: Team 1032 Yes we CANSAT | 102
Req # | Description | Comply / No Comply / Partial | X-Ref Slide(s) Demonstrating Compliance | Team comments or notes
1 | grams +/- 10 grams. Total mass of the CanSat (science payloads and container) shall be 700 | Partial | 17 | Additional Components to be added
2 | CanSat shall fit in a cylindrical envelope of 125 mm diameter x 400 mm length. Tolerances are to be included to facilitate container deployment from the rocket fairing. | Comply | 17
3 | The container shall not have any sharp edges to cause it to get stuck in the rocket payload section which is made of cardboard. | Comply | 19 | Sides will be sanded
4 | The container shall be a fluorescent color; pink, red or orange. | Comply | 44, 99
5 | The container shall be solid and fully enclose the science probes. Small holes to allow access to turn on the science probes are allowed. The end of the container where the probe deploys may be open. | No comply | | To be added
6 | The rocket airframe shall not be used to restrain any deployable parts of the CanSat. | Comply | 41
7 | The rocket airframe shall not be used as part of the CanSat operations. | Comply | 41
8 | The container’s parachute shall not be enclosed in the container structure. It shall be external and attached to the container so that it opens immediately when deployed from the rocket. | Comply | 44
9 | The Parachutes shall be fluorescent Pink or Orange | Comply | 99
10 | The descent rate of the CanSat (container and science probe) shall be 15 meters/second +/- 5m/s. | Comply | 38

# (If You Want) Requirements Compliance

103

Req # | Description | Comply / No Comply / Partial | X-Ref Slide(s) Demonstrating Compliance | Team comments or notes
11 | 0 altitude reference shall be at the launch pad. | Comply | 85
12 | All structures shall be built to survive 15 Gs of launch acceleration. | Comply | 39 | Needs Testing
13 | All structures shall be built to survive 30 Gs of shock | Comply | 39 | Needs Testing
14 | All electronics and mechanical components shall be hard mounted using proper mounts such as standoffs, screws, or high-performance adhesives. | Comply | 41-46
15 | All mechanisms shall be capable of maintaining their configuration or states under all forces. | No Comply | 39 | Needs Testing
16 | Mechanisms shall not use pyrotechnics or chemicals. | Comply | 41
17 | Mechanisms that use heat (e.g., nichrome wire) shall not be exposed to the outside environment to reduce potential risk of setting vegetation on fire. | Comply | 41
18 | Both the container and payload shall be labeled with team contact information including email address. | Comply | 99
19 | Cost of the CanSat shall be under $1000. Ground support and analysis tools are not included in the cost. Equipment from previous years should be included in this cost, based on current market value. | Comply | 51-55
20 | XBEE radios shall be used for telemetry. 2.4 GHz Series radios are allowed. 900 MHz XBEE radios are also allowed. | Comply | 60
21 | XBEE radios shall have their NETID/PANID set to their team number. | Comply | 60
Presenter: Savari Datta | CanSat 2023 PDR: Team 1032 Yes we CANSAT

# (If You Want) Requirements Compliance

104

Req # | Description | Comply / No Comply / Partial | X-Ref Slide(s) Demonstrating Compliance | Team comments or notes
22 | XBEE radios shall not use broadcast mode. | Comply | 60
23 | The container and probe shall include an easily accessible power switch that can be accessed without disassembling the CanSat and science probes and in the stowed configuration. | Partial | 67,68
24 | The probe shall include a power indicator such as an LED or sound generating device that can be easily seen or heard without disassembling the CanSat and in the stowed state. | Comply | 67
25 | An audio beacon is required for the probe. It shall be powered after landing. | Comply | 67, 75
26 | The audio beacon shall have a minimum sound pressure level of 92 dB, unobstructed. | Partial | 28 | Mid-implementation
27 | Battery source may be alkaline, Ni-Cad, Ni-MH or Lithium. Lithium polymer batteries are not allowed. Lithium cells must be manufactured with a metal package similar to 18650 cells. Coin cells are allowed. | Comply | 68
28 | An easily accessible battery compartment shall be included allowing batteries to be installed or removed in less than a minute and not require a total disassembly of the CanSat. | Partial | 17 | Mid-implementation
29 | Spring contacts shall not be used for making electrical connections to batteries. Shock forces can cause momentary disconnects. | Comply | 81-89
30 | The Cansat shall operate during the environmental tests laid out in Section 3.5. | Comply | 93
31 | The Cansat shall operate for a minimum of two hours when integrated into the rocket. | Comply | 58
32 | The probe shall be released from the container when the CanSat reaches 500 meters. | Comply | 45
Presenter: Savari Datta | CanSat 2023 PDR: Team 1032 Yes we CANSAT

# (If You Want) Requirements Compliance

105

Req # | Description | Comply / No Comply / Partial | X-Ref Slide(s) Demonstrating Compliance | Team comments or notes
33 | The probe shall deploy a heat shield after leaving the container. | Comply | 47-48
34 | The heat shield shall be used as an aerobrake and limit the descent rate to 20 m/s or less. | Comply | 31, 35-34
35 | At 200 meters, the probe shall release a parachute to reduce the descent rate to 5 m/s +/- 1m/sec. | Comply | 49, 38
36 | Once landed, the probe shall upright itself. | Partial | 50 | No active uprighting
37 | After uprighting, the probe shall deploy a flag 500 mm above the base of the probe when the probe is in the upright position. | Comply | 41
38 | The probe shall transmit telemetry once per second. | Comply | 60, 75, 92
39 | The probe telemetry shall include altitude, air pressure, temperature, battery voltage, probe tilt angles, command echo, and GPS coordinates that include latitude, longitude, altitude and number of satellites tracked. | Comply | 61
40 | The probe shall include a video camera pointing down to the ground. | Comply | 28
41 | The video camera shall record the flight of the probe from release to landing. | Comply | 28
42 | The video camera shall record video in color and with a minimum resolution of 640x480. | Comply | 28
44 | The flight software shall maintain a count of packets transmitted which shall increment with each packet transmission throughout the mission. The value shall be maintained through processor resets | Comply | 61
45 | The probe shall maintain mission time throughout the whole mission even with processor resets or momentary power loss. | Comply | 61
Presenter: Savari Datta | CanSat 2023 PDR: Team 1032 Yes we CANSAT

# (If You Want) Requirements Compliance

106

Req # | Description | Comply / No Comply / Partial | X-Ref Slide(s) Demonstrating Compliance | Team comments or notes
46 | The probe shall have its time set to within one second UTC time prior to launch. | Comply | 64
47 | The probe flight software shall support simulated flight mode where the ground station sends air pressure values at a one second interval using a provided flight profile csv file. | No Comply | | To be added
48 | In simulation mode, the flight software shall use the radio uplink pressure values in place of the pressure sensor for determining the container altitude. | No Comply | | To be added
49 | The container flight software shall only enter simulation mode after it receives the SIMULATION ENABLE and SIMULATION ACTIVATE commands. | Comply | 63, 65, 94
50 | The ground station shall command the CanSat to start calibrating the altitude to zero when the CanSat is on the launch pad prior to launch. | Comply | 64
51 | The ground station shall generate csv files of all sensor data as specified in the Telemetry Requirements section. | Comply | 86
52 | Telemetry shall include mission time with 0.01 second or better resolution. | Comply | 61
53 | Configuration states such as zero altitude calibration shall be maintained in the event of a processor reset during launch and mission. | Comply | 73
54 | Each team shall develop their own ground station. | Comply | 81
55 | All telemetry shall be displayed in real time during descent on the ground station. | Comply | 85
56 | All telemetry shall be displayed in engineering units (meters, meters/sec, Celsius, etc.) | Comply | 85
Presenter: Savari Datta | CanSat 2023 PDR: Team 1032 Yes we CANSAT

# (If You Want) Requirements Compliance

107

Req # | Description | Comply / No Comply / Partial | X-Ref Slide(s) Demonstrating Compliance | Team comments or notes
57 | Teams shall plot each telemetry data field in real time during flight. | Comply | 85
58 | The ground station shall include one laptop computer with a minimum of two hours of battery operation, XBEE radio and a hand-held antenna. | Comply | 81
59 | The ground station must be portable so the team can be positioned at the ground station operation site along the flight line. AC power will not be available at the ground station operation site | Comply | 81
60 | The ground station software shall be able to command the container to operate in simulation mode by sending two commands, SIMULATION ENABLE and SIMULATION ACTIVATE. | Comply | 84, 94
61 | When in simulation mode, the ground station shall transmit pressure data from a csv file provided by the competition at a 1 Hz interval to the cansat. | Comply | 84, 94
Presenter: Savari Datta | CanSat 2023 PDR: Team 1032 Yes we CANSAT

# Management

# Savari Datta

CanSat 2023 PDR: Team 1032 Yes we CANSAT | 108

(If You Want) | CanSat Budget – Hardware (1/2)
Presenter: Savari Datta | CanSat 2023 PDR: Team 1032 Yes we CANSAT | 109
Component | Quantity | Unit Price ($) | Total Price ($) | Value Type
Adafruit BMP280 | 2 | 9.95 | 19.90 | Actual
BNO-055 | 1 | 34.95 | 34.95 | Actual
Adafruit Ultimate | 1 | 29.95 | 29.95 | Actual
Raspberry Pi Pico | 1 | 4.50 | 4.50 | Actual
ANT-900-RP-2-A | 1 | 3.99 | 3.99 | Actual
Arducam Mini | 1 | 25.99 | 25.99 | Actual
Mirco SD cards | 1 | 4.20 | 4.20 | Actual
Micro SD Readers | 1 | 8.00 | 8.00 | Actual
XBEE Pro 900 Mhz Radio | 1 | 68.25 | 68.25 | Actual
2032 Cell Batteries | 4 | 1.20 | 4.80 | Actual
Arduino Nano | 1 | 20.70 | 20.70 | Actual
ABS Filament 1.75mm ABS, 1 kg | 1 | 22.99 | 22.99 | Actual
Springs | 6 | 2.32 | 13.92 | Actual
Tie Down Ring | 1 | 1.24 | 1.24 | Actual

(If You Want) | CanSat Budget – Hardware (2/2)
Presenter: Savari Datta | CanSat 2023 PDR: Team 1023 Yes we CANSAT | 110
Component | Quantity | Unit Price ($) | Total Price ($) | Value Type
Linear Actuator | 1 | 65.00 | 65.00 | Actual
Servo Motor | 1 | 8.84 | 8.84 | Actual
¼-20 Hex Nut | 2 | 9.81 | 9.81 | Actual
Steel Tape | 1 | 14.99 | 14.99 | Actual
Super Lube | 1 | 7.39 | 7.39 | Actual
Clock Spring | 1 | 8.38 | 8.38 | Actual
JB Weld Plastic Bonder | 1 | 15.74 | 15.74 | Actual
Fiberglass Eyebolt | 1 | 5.66 | 5.66 | Actual
Aluminum Poles | 1 | 5.00 | 5.00 | Estimate
¼ -20 Screw | 1 | 13.84 | 13.84 | Actual
Mylar Reflective Material | 1 | 26.00 | 26.00 | Actual
Aluminum Strip | 1 | 6.93 | 6.93 | Actual
Parachutes | 2 | 17.95 | 35.90 | Actual
Plastic Coupling Nuts | 4 | 5.55 | 22.20 | Actual
PCB Screws | 4 | 1.25 | 5.00 | Actual

(If You Want) | CanSat Budget – Other Costs (1/2)
Presenter: Savari Datta | CanSat 2023 PDR: Team 1032 Yes we CANSAT | 111
Component | Quantity | Unit Price ($) | Total Price ($) | Value Type
Ground Station | - | - | - | -
Xbee USB Shield | 1 | 26.00 | 26.00 | Actual
900 MHz 14 dBi Al Yagi Antenna | 1 | 72.32 | 72.32 | Actual
900 MHz XBEE Radio | 1 | 68.25 | 68.25 | Actual
Laptop | 1 | 1 | 0 | Provided by Team Member
Prototyping | 1 | 1 | 150.00 | Estimate
Test Supplies | 1 | 1 | 150.00 | Estimate
Test Facilities/ Manufacturing Equipment | 1 | 1 | 0 | Covered by University

(If You Want) | CanSat Budget – Other Costs (2/2)
Presenter: Savari Datta | CanSat 2023 PDR: Team 1032 Yes we CANSAT | 112
Source of Income: | Funds Provided ($):
UF MAE Department | 4000.00
Hardware Costs: | $514.06
Other Costs: | $466.57
Competition Fees: | $200.00
Total Costs: | $1180.63

## A total cost of $1057.09 for the testing and building of our CanSat as well as CanSat related fees leaves us with a total of $2819.37 for travel, housing, and food expense. This is expected to be more than

sufficient for our 10 members.

(If You Want) | Program Schedule Overview

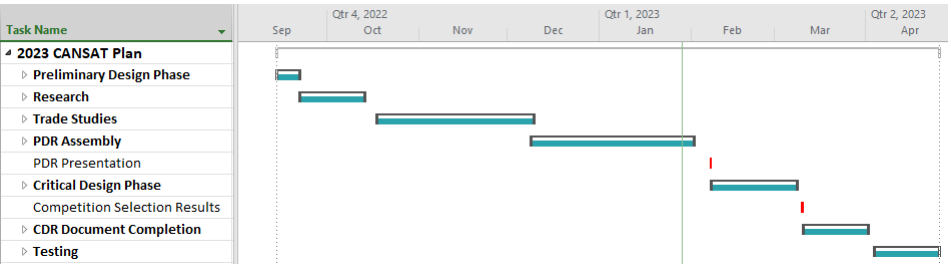
[picture p105: figure]

Presenter: Savari Datta | CanSat 2023 PDR: Team 1032 Yes we CANSAT | 113
- The schedule below is a broad overlook of the 2022-2023 completion schedule for our team
- The key below defines symbols for the more detailed schedule
Design Phase Overview | Important Action
Task | Holiday/Vacation

KEY

# (If You Want) Detailed Program Schedule (1/2)

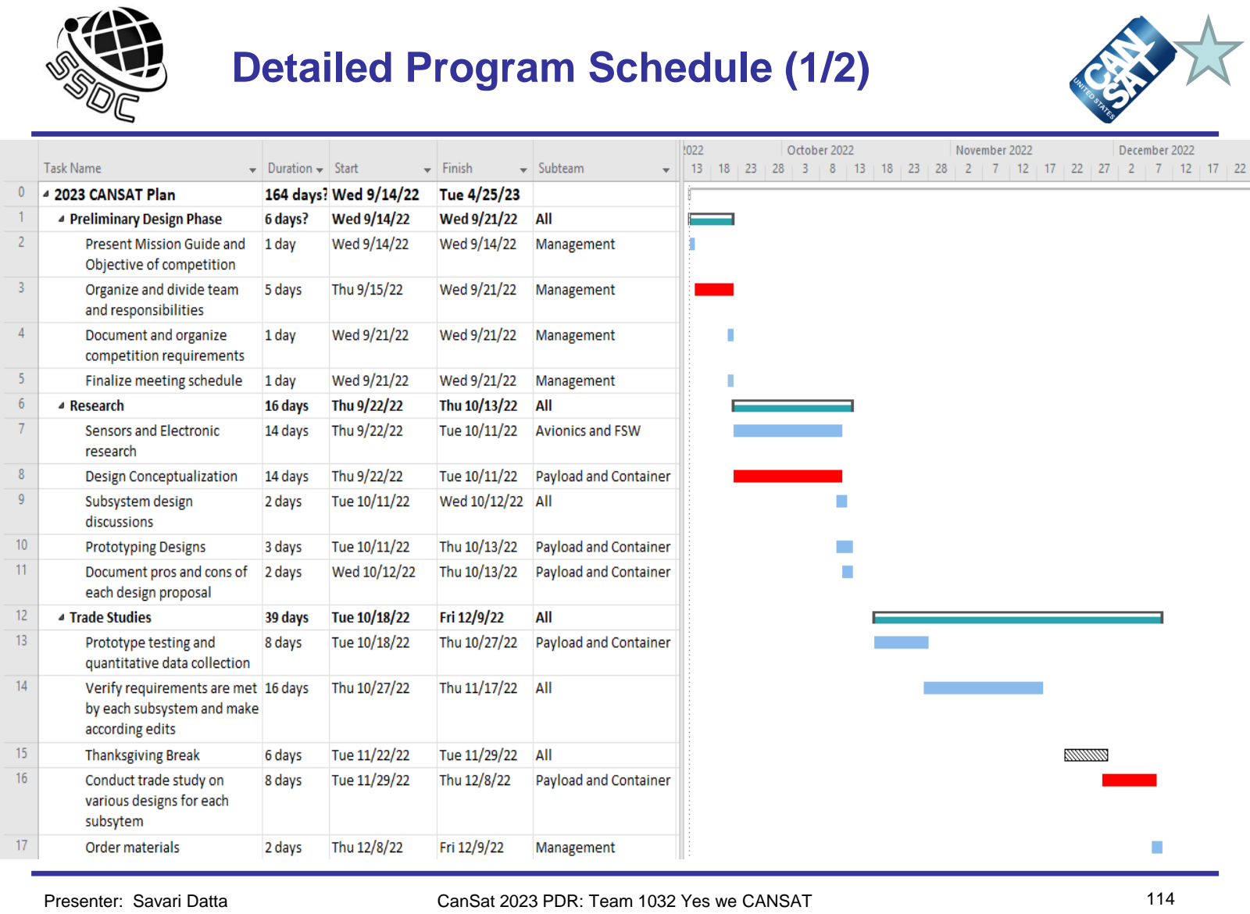
[picture p106: page 114]

Presenter: Savari Datta | CanSat 2023 PDR: Team 1032 Yes we CANSAT | 114

# (If You Want) Detailed Program Schedule (2/2)

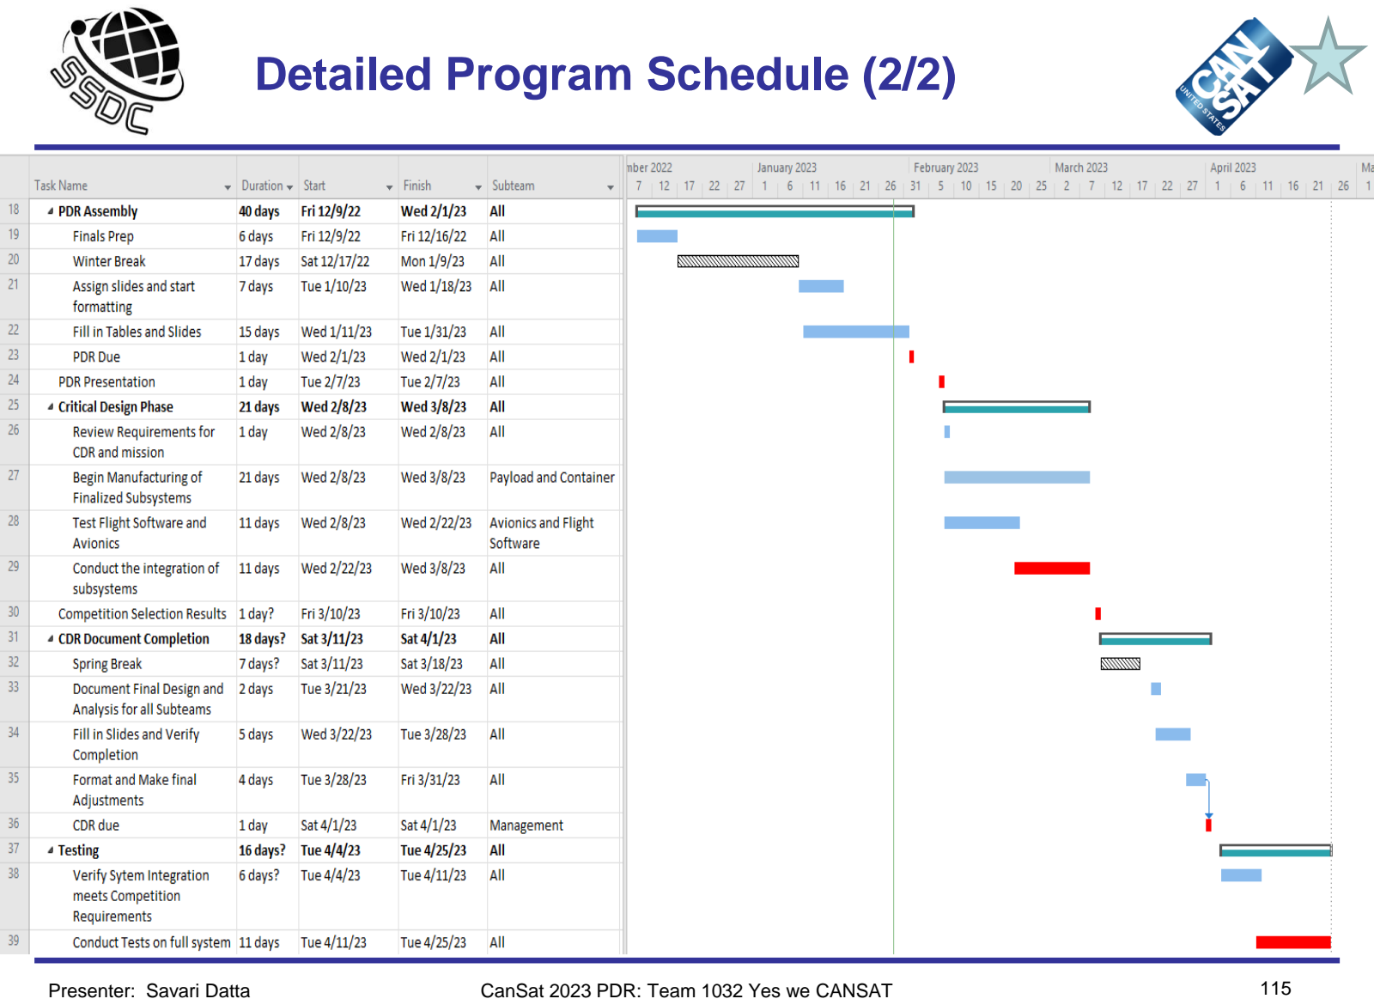
[picture p107: page 115]

Presenter: Savari Datta | CanSat 2023 PDR: Team 1032 Yes we CANSAT | 115

(If You Want) | Conclusions
Presenter: Savari Datta | CanSat 2023 PDR: Team 1032 Yes we CANSAT | 116

## Major Accomplishments

- All electronics have been purchased and ordered
- Parachute testing has been conducted
- Payload subsystem has run preliminary testing
- Majority of telemetry components programmed
- Avionics communication and data handling in progress
- Significant funding secured

## Major Unfinished Work

- Prototype of CanSat
- Telemetry communication tests between payload, container, and Ground Station
- Manufactured container and payload
- Definitive plan to enclose container and payload

## Justification for Next Stage

- Major goals for each subsystem outlined and in progress
- Testing on descent has started
- Full team engaged and dedicated to success
